mofe64/roadRunnerMiniV1/cad/biped_v02/renders_s68/s68_1_wall_outside_left.png

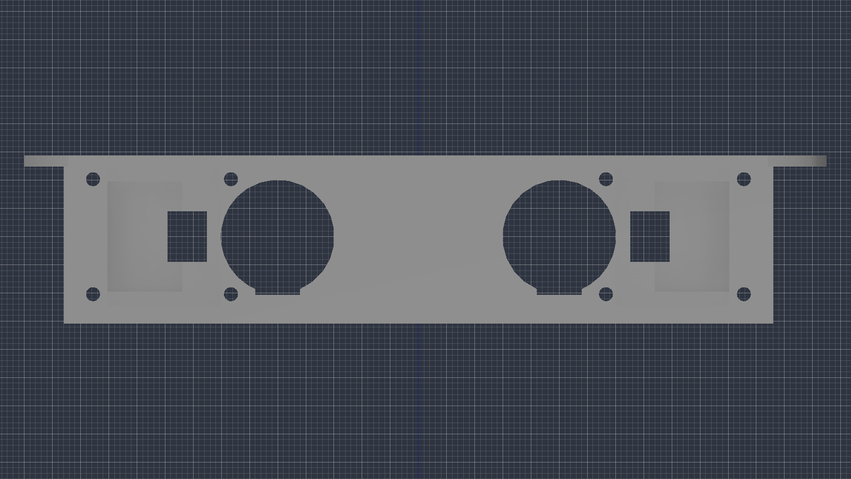
cad/biped_v02/renders_s68/s68_1_wall_outside_left.png
