mofe64/roadRunnerMiniV1/cad/biped_v02/renders_s68/s68_3_iso_with_hip_servos.png

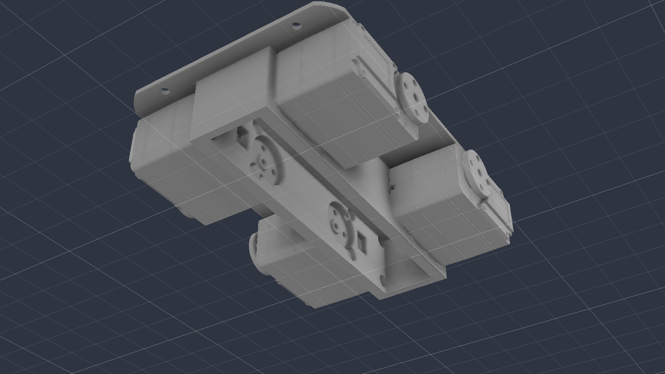
cad/biped_v02/renders_s68/s68_3_iso_with_hip_servos.png
