mofe64/roadRunnerMiniV1/cad/biped_v02/renders_s69/s69_1_base_top.png

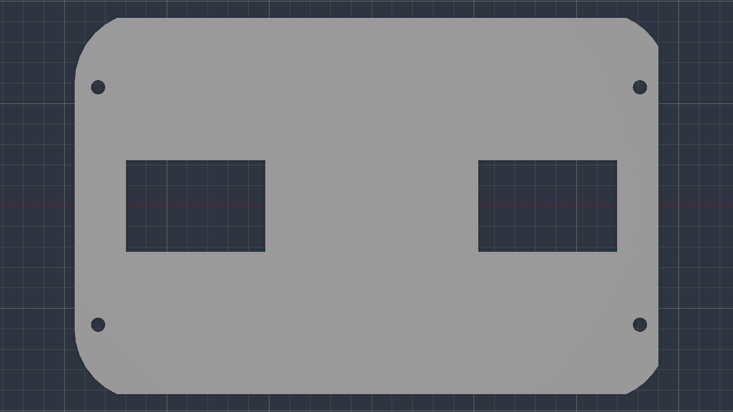
cad/biped_v02/renders_s69/s69_1_base_top.png
