mofe64/roadRunnerMiniV1/cad/biped_v02/renders_s69/s69_2_base_iso.png

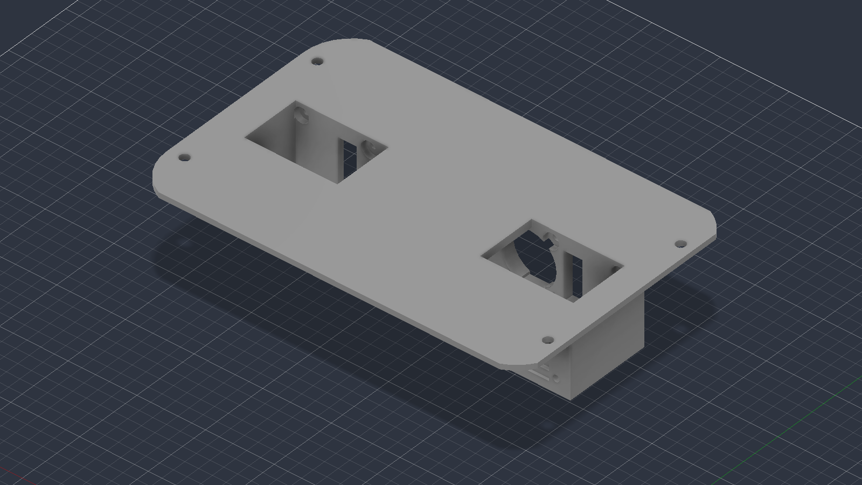
cad/biped_v02/renders_s69/s69_2_base_iso.png
