mofe64/roadRunnerMiniV1/cad/biped_v02/renders_s69/s69_3_base_iso_servos.png

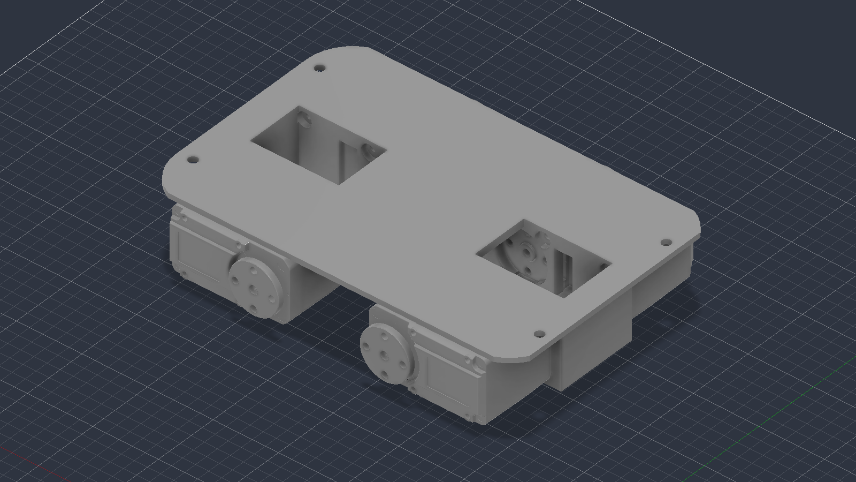
cad/biped_v02/renders_s69/s69_3_base_iso_servos.png
