mofe64/roadRunnerMiniV1/cad/biped_v02/renders_s70/s70_1_upper_front_pads.png

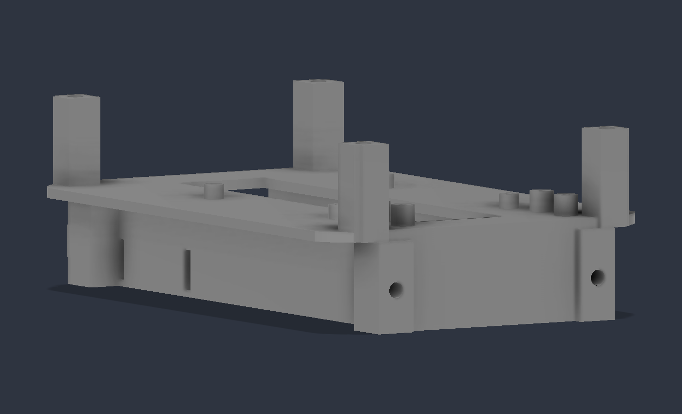
cad/biped_v02/renders_s70/s70_1_upper_front_pads.png
