mofe64/roadRunnerMiniV1/cad/biped_v02/renders_s70/s70_2_tray_front.png

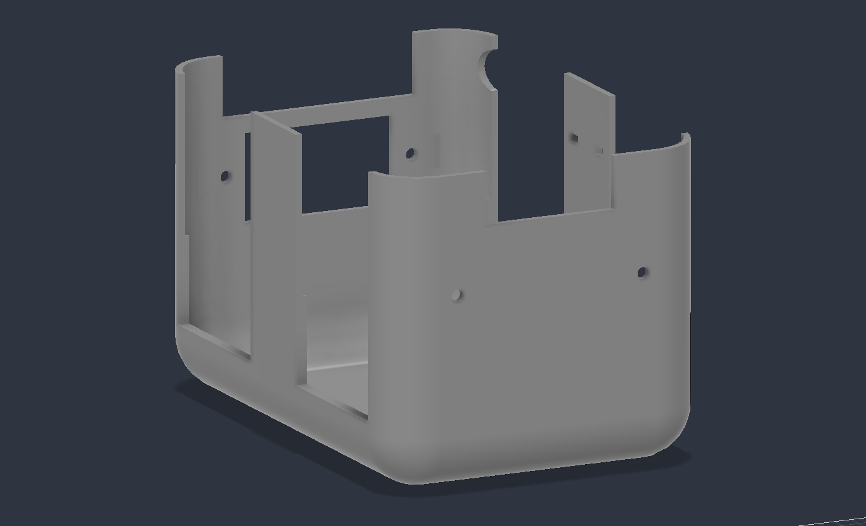
cad/biped_v02/renders_s70/s70_2_tray_front.png
