mofe64/roadRunnerMiniV1/cad/biped_v02/renders_s70/s70_3_deck_top.png

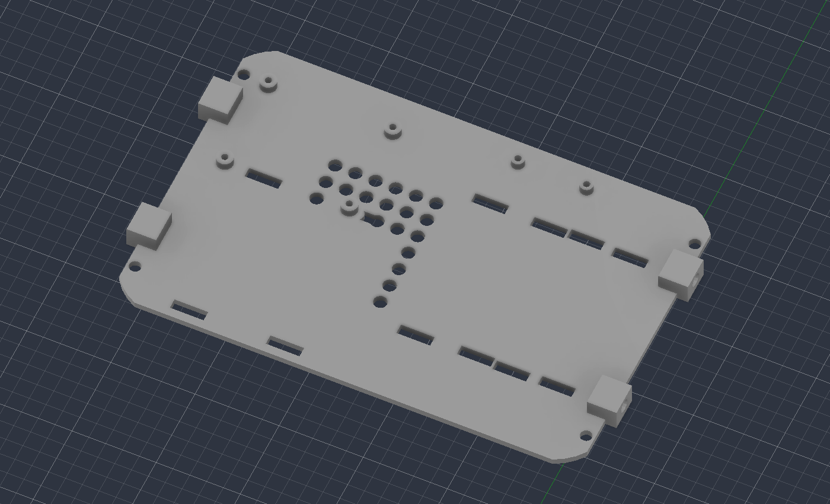
cad/biped_v02/renders_s70/s70_3_deck_top.png
