mofe64/roadRunnerMiniV1/cad/biped_v02/renders_s72/s72_deck_iso.png

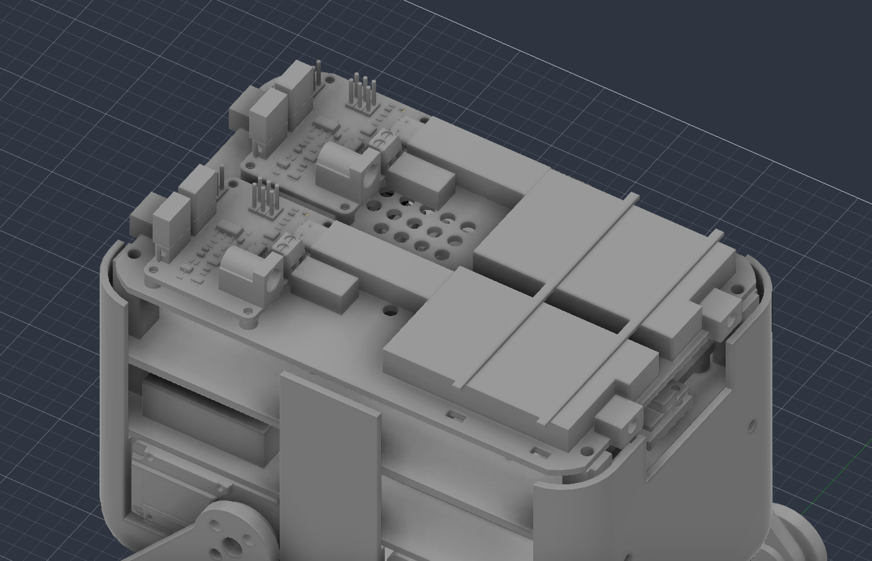
cad/biped_v02/renders_s72/s72_deck_iso.png
