mofe64/roadRunnerMiniV1/renders/biped_v02/v02c_iso_front.png

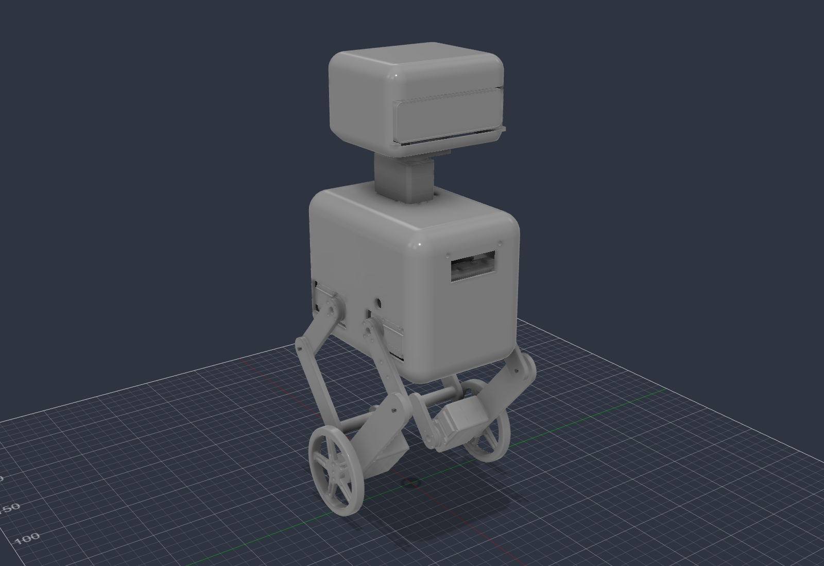
renders/biped_v02/v02c_iso_front.png
