mofe64/roadRunnerMiniV1/renders/biped_v02/v02c_neck_closeup.png

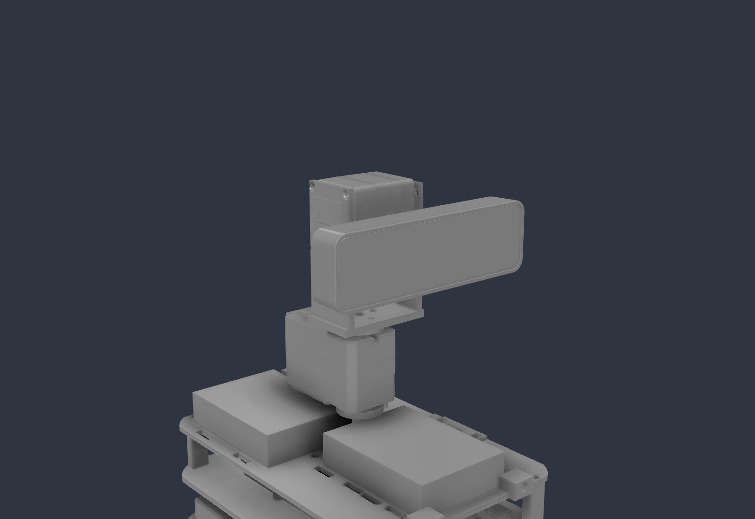
renders/biped_v02/v02c_neck_closeup.png
