mofe64/roadRunnerMiniV1/renders/biped_v02/v02d_oak_mount.png

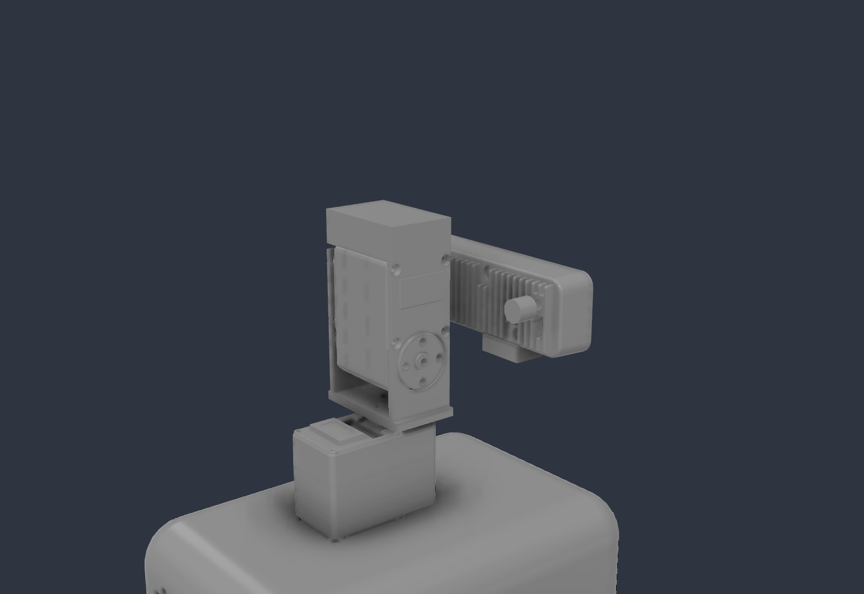
renders/biped_v02/v02d_oak_mount.png
