mofe64/roadRunnerMiniV1/renders/neck/bracket_top.png

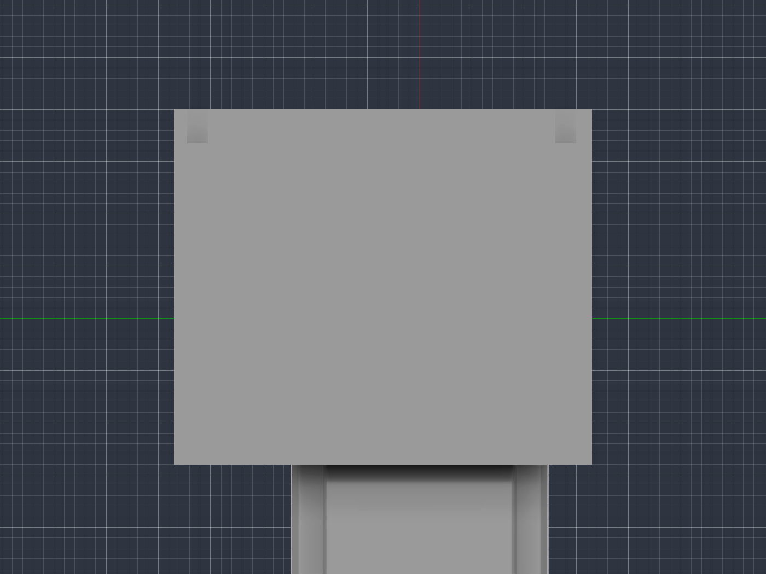
renders/neck/bracket_top.png
