mofe64/roadRunnerMiniV1/renders/neck/bracket_underside.png

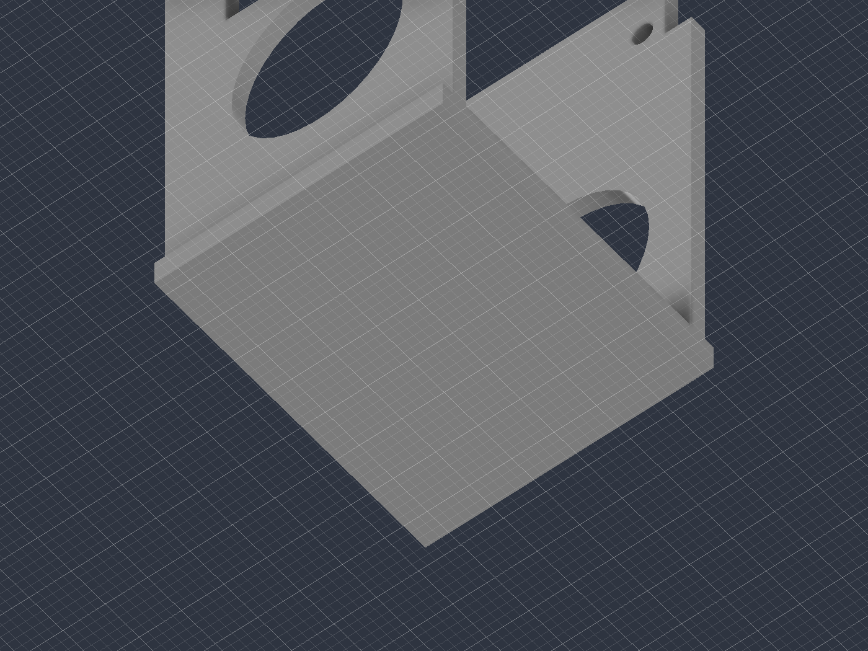
renders/neck/bracket_underside.png
