mofe64/roadRunnerMiniV1/renders/neck/head_below_drive.png

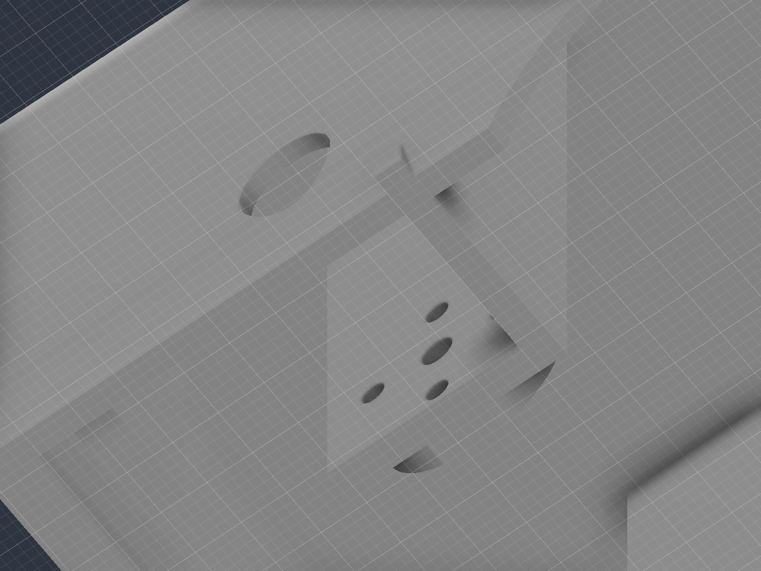
renders/neck/head_below_drive.png
