mofe64/roadRunnerMiniV1/renders/neck/head_side_drive.png

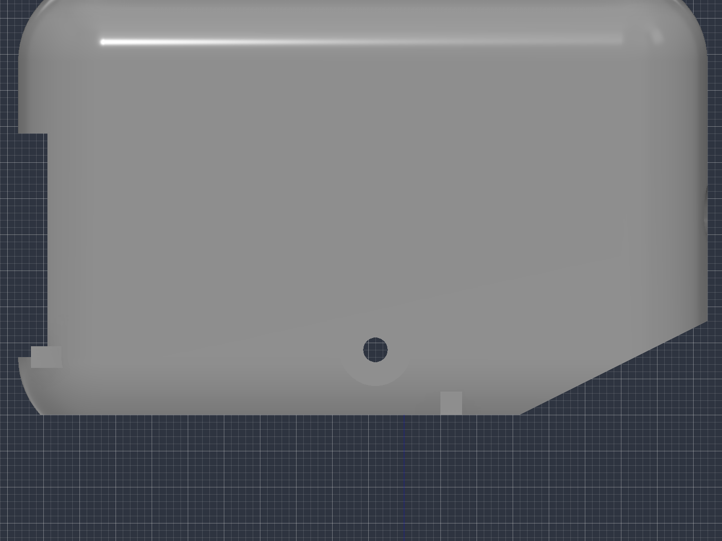
renders/neck/head_side_drive.png
