mofe64/roadRunnerMiniV1/renders/neck/plain_front_below.png

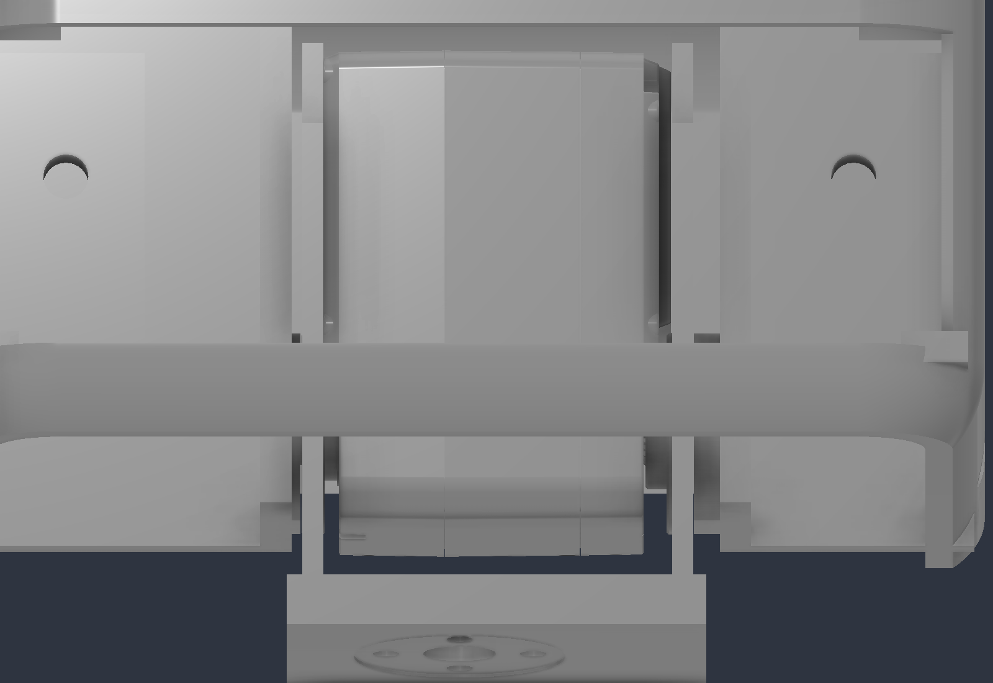
renders/neck/plain_front_below.png
