mofe64/roadRunnerMiniV1/renders/neck/s54_lid_top.png

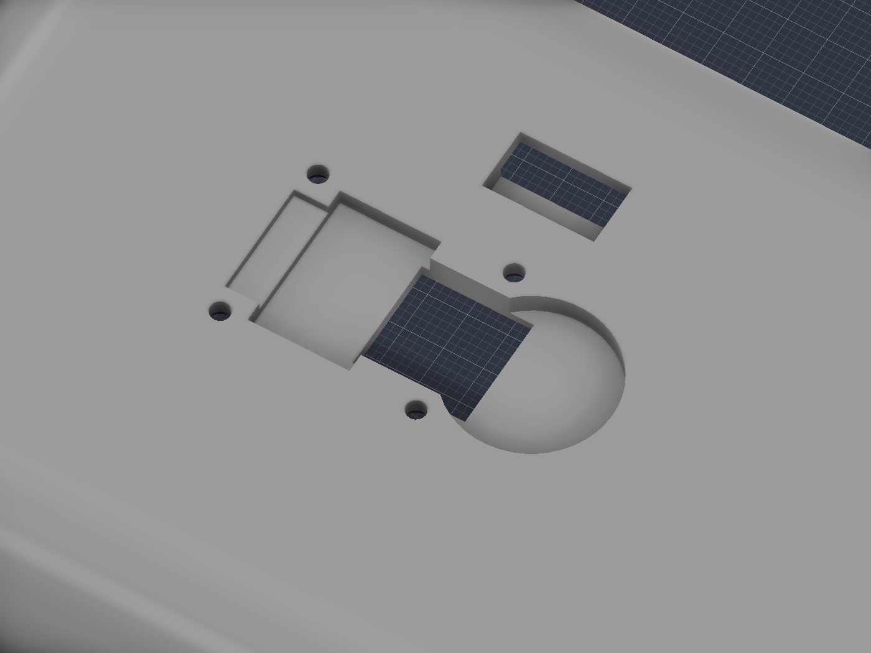
renders/neck/s54_lid_top.png
