mofe64/roadRunnerMiniV1/renders/neck/s54_neck_side.png

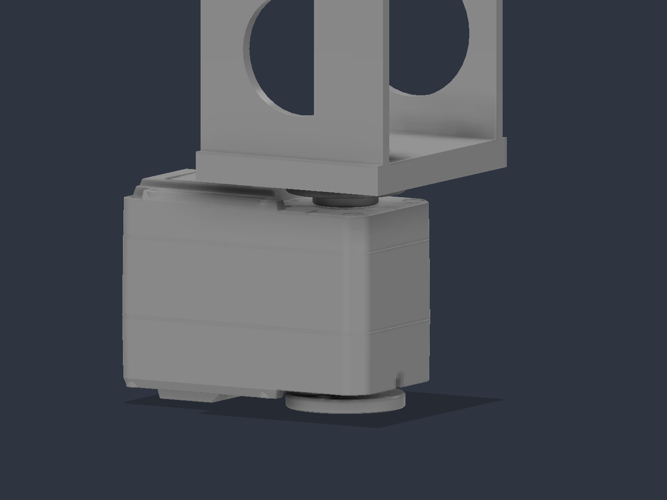
renders/neck/s54_neck_side.png
