mofe64/roadRunnerMiniV1/renders/neck/s54_neck_with_lid.png

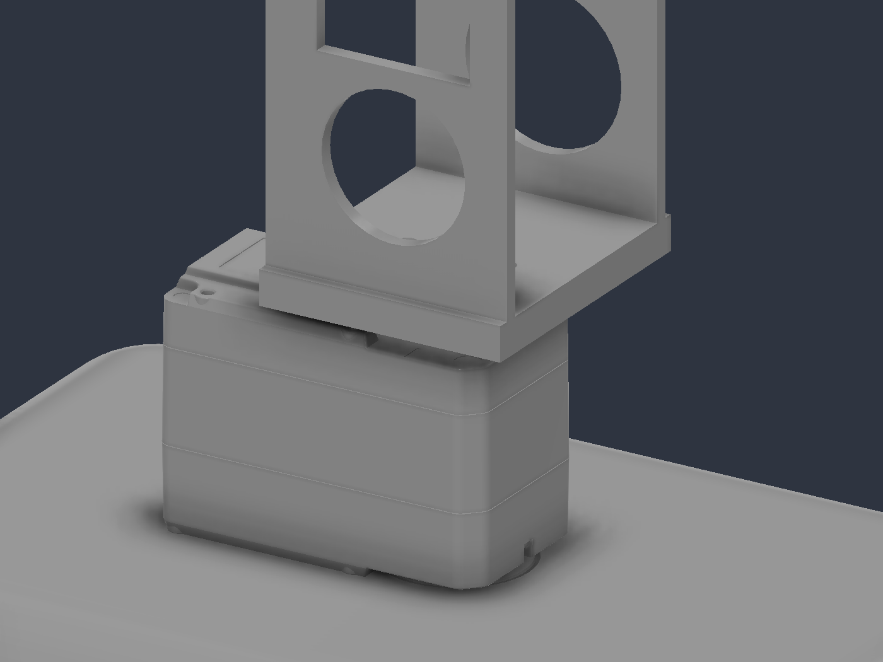
renders/neck/s54_neck_with_lid.png
