mofe64/roadRunnerMiniV1/renders/neck/yaw_below.png

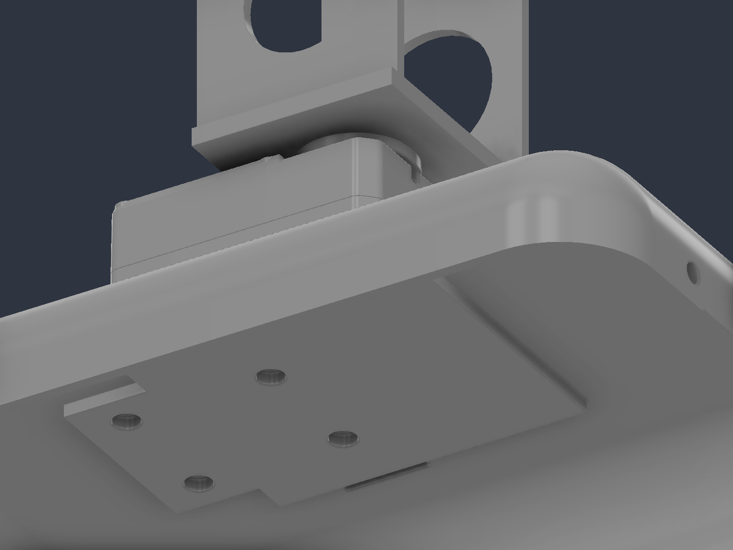
renders/neck/yaw_below.png
