mofe64/roadRunnerMiniV1/renders/neck/yaw_nolid_below.png

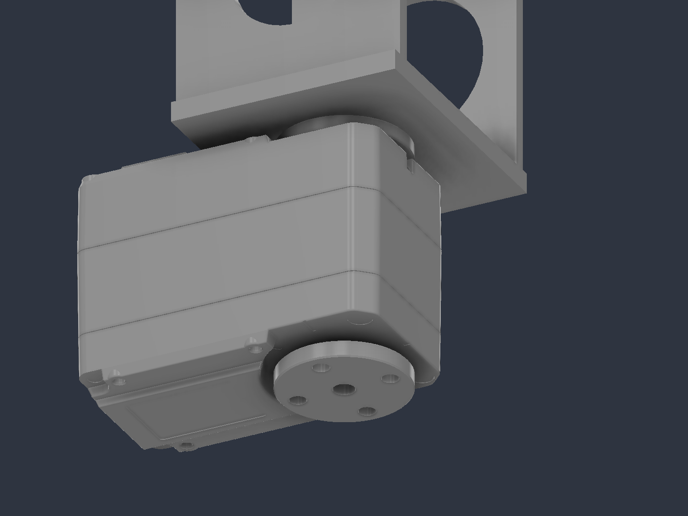
renders/neck/yaw_nolid_below.png
