mofe64/roadRunnerMiniV1/renders/neck/yaw_side.png

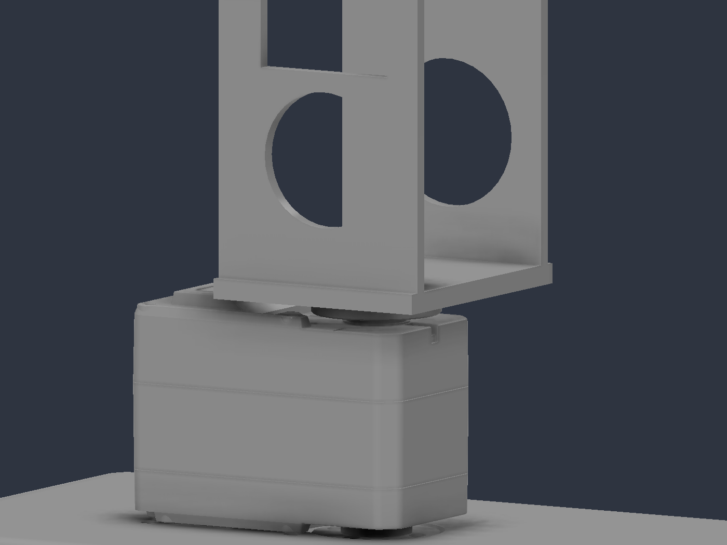
renders/neck/yaw_side.png
