mofe64/roadRunnerMiniV1/renders/s65_iso_robot.png

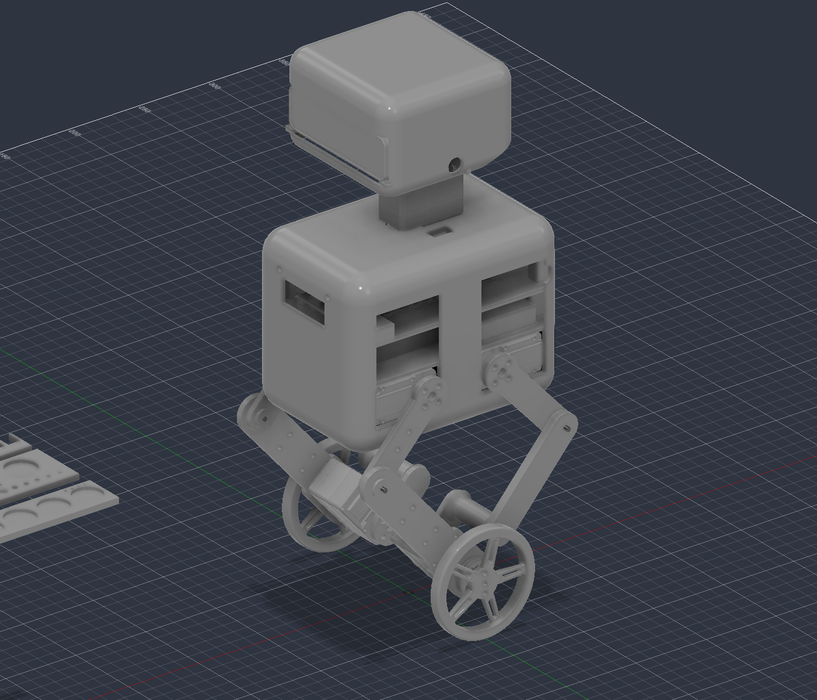
renders/s65_iso_robot.png
