mofe64/roadRunnerMiniV1/renders/s65_iso_tray_close.png

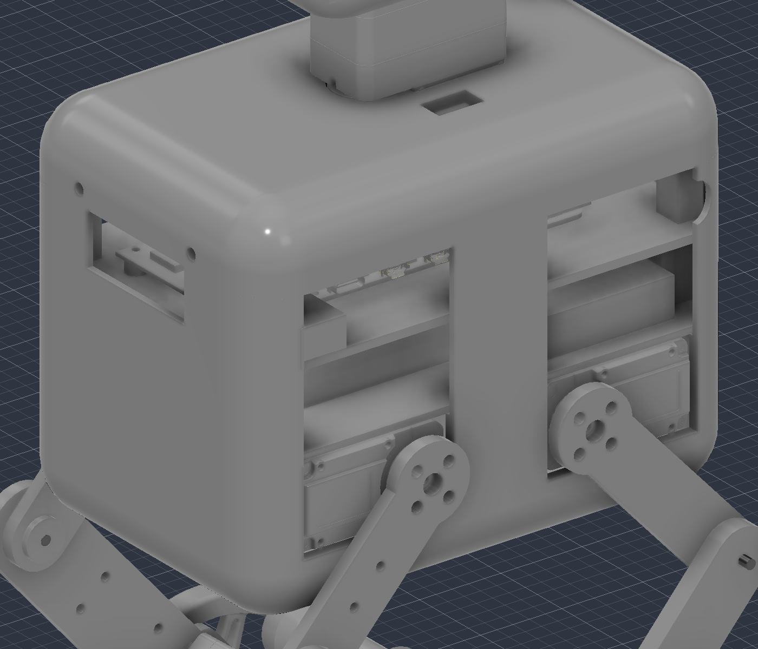
renders/s65_iso_tray_close.png
