mofe64/roadRunnerMiniV1/renders/s65_side_left.png

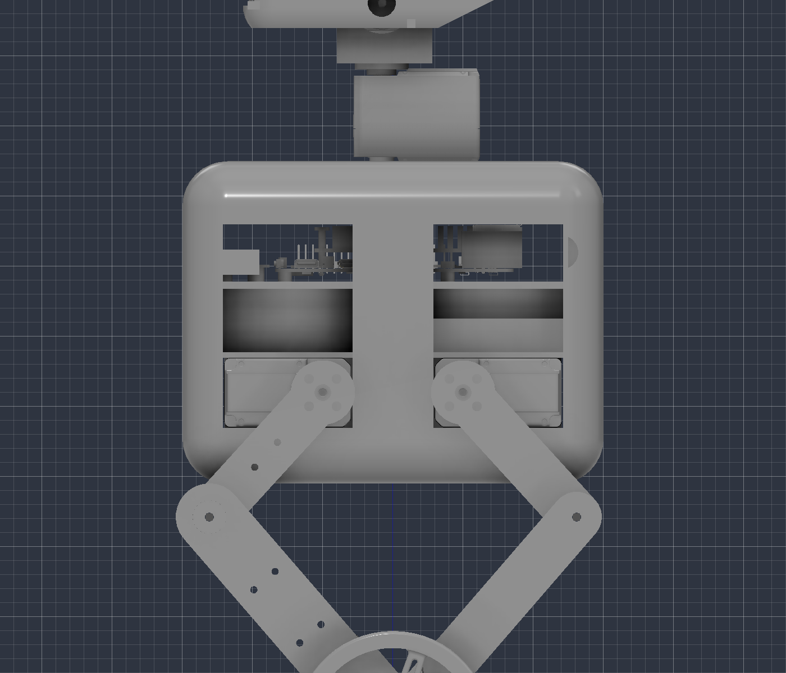
renders/s65_side_left.png
