mofe64/roadRunnerMiniV1/renders/wheeled_biped_references.jpg

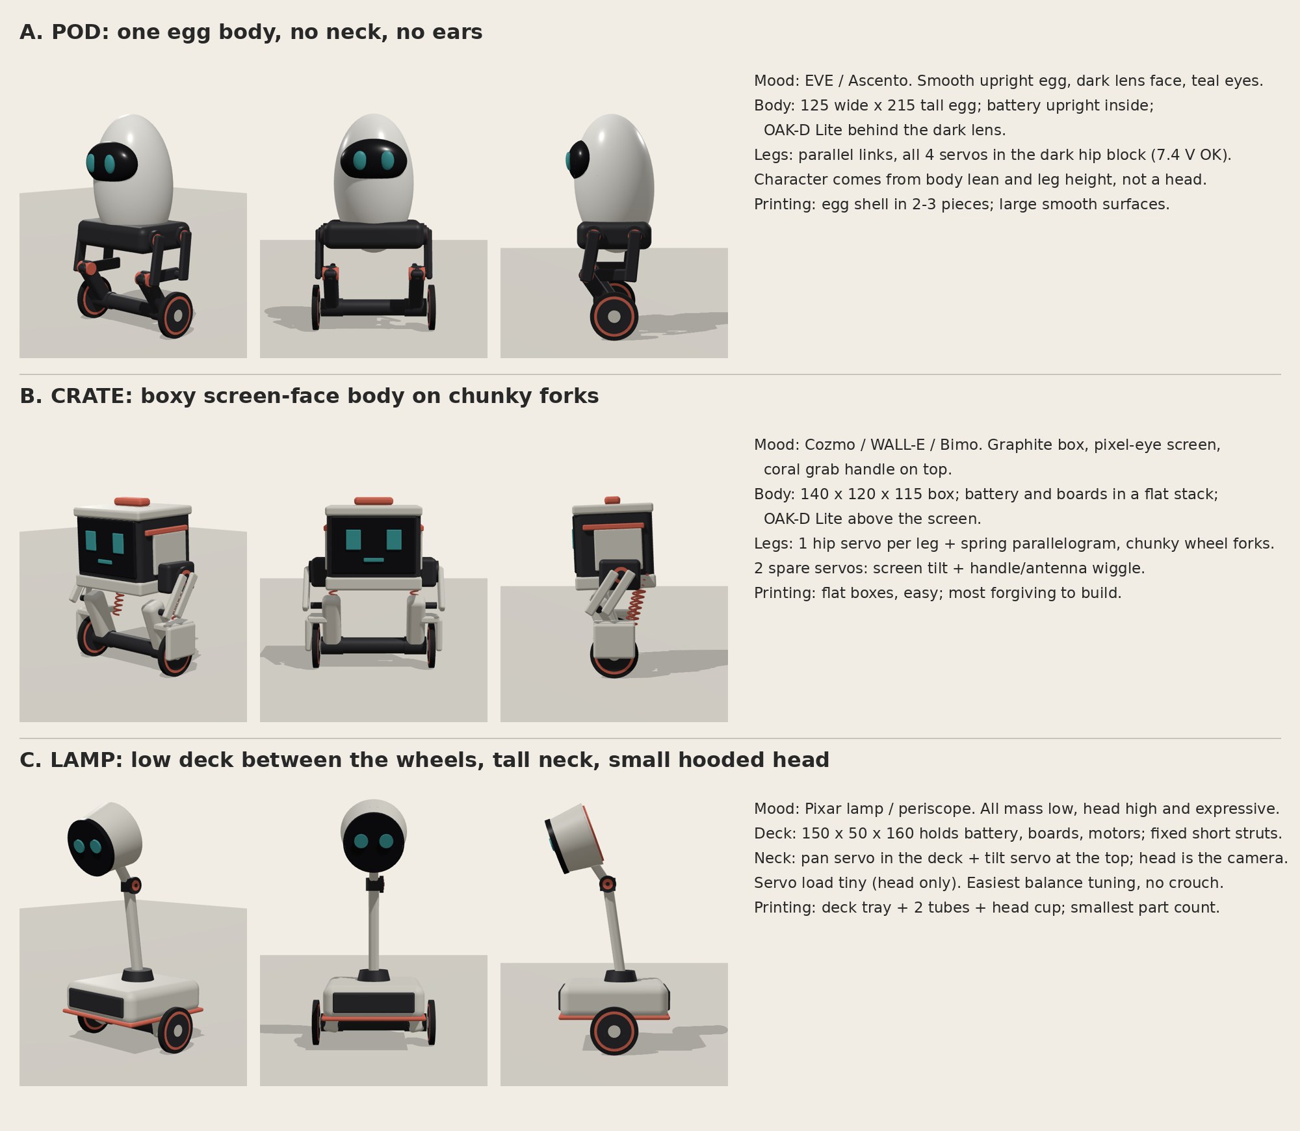
renders/wheeled_biped_references.jpg
