mofe64/roadRunnerMiniV1/cad/biped_v02/coupon/coupon_plate.stl

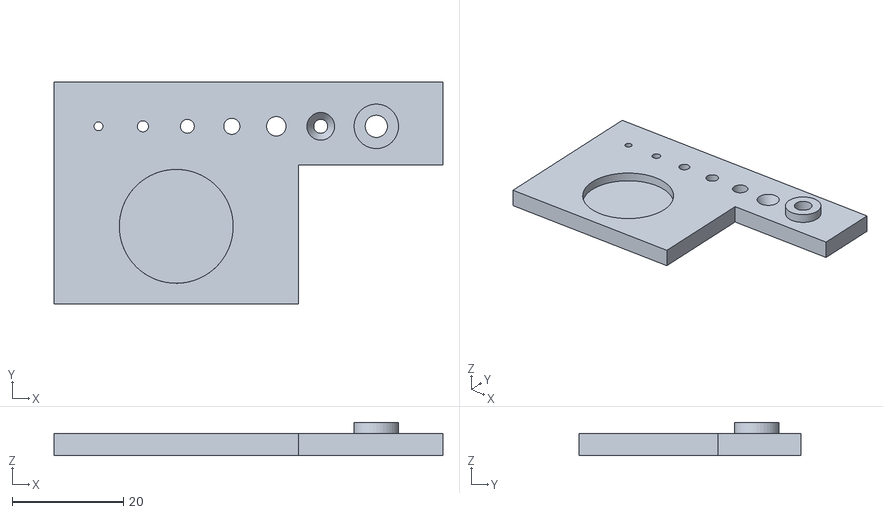
[picture p29: CAD file, 2026-10-27]
cad/biped_v02/coupon/coupon_plate.stl
70.0 x 40.0 x 6.00
