mofe64/roadRunnerMiniV1/cad/biped_v02/plates/plate_9_imu_plate.3mf

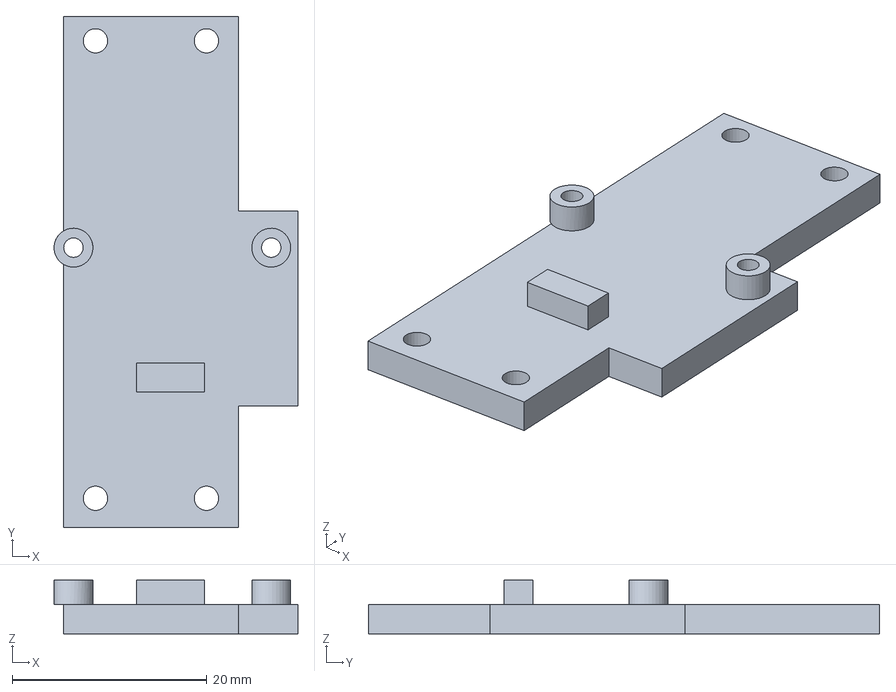
[picture p30: CAD file, 2026-11-11]
cad/biped_v02/plates/plate_9_imu_plate.3mf
25.1 x 52.5 x 5.50 mm
