mofe64/roadRunnerMiniV1/cad/biped_v02/stl/upper_deck.stl

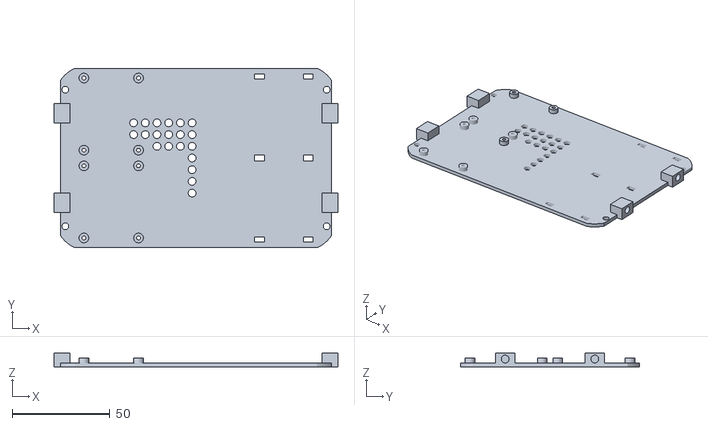
[picture p31: CAD file, 2026-11-11]
cad/biped_v02/stl/upper_deck.stl
145.6 x 92.0 x 7.00
