mofe64/roadRunnerMiniV1/sim/meshes/torso_pi.stl

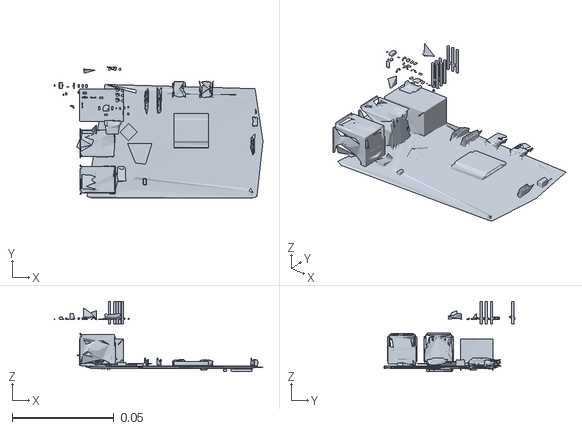
[picture p32: CAD file, 2026-10-31]
sim/meshes/torso_pi.stl
0.103 x 0.0646 x 0.0346
