mofe64/roadRunnerMiniV1/sim/meshes_raw/oak.stl

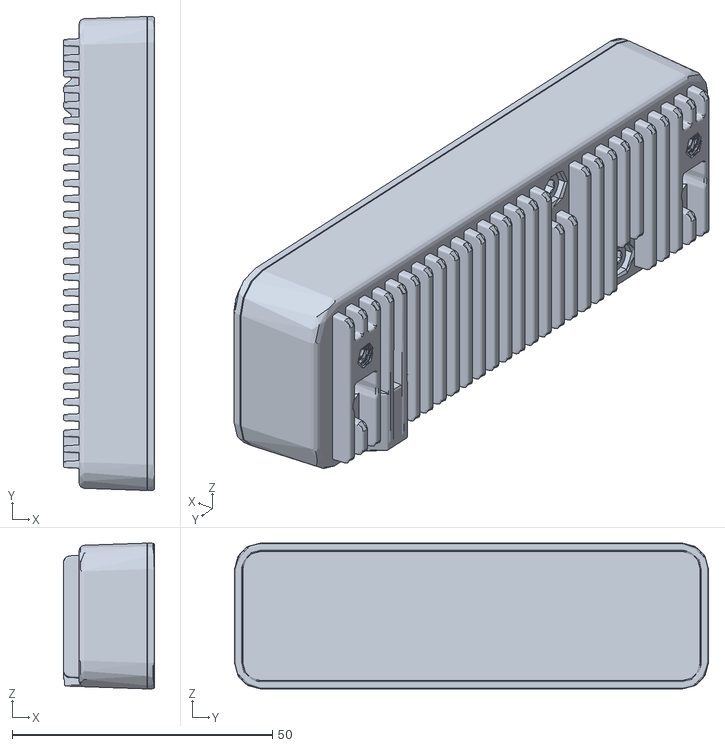
[picture p33: CAD file, 2026-10-31]
sim/meshes_raw/oak.stl
17.4 x 91.0 x 28.0
