mofe64/roadRunnerMiniV1/cad/biped_v02/coupon/coupon_all.stl

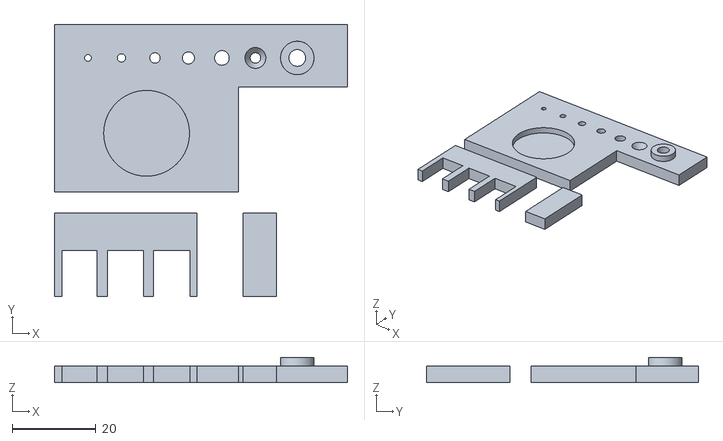
[picture p34: CAD file, 2026-10-27]
cad/biped_v02/coupon/coupon_all.stl
70.0 x 65.0 x 6.00
