mofe64/roadRunnerMiniV1/sim/meshes/low_f_L.stl

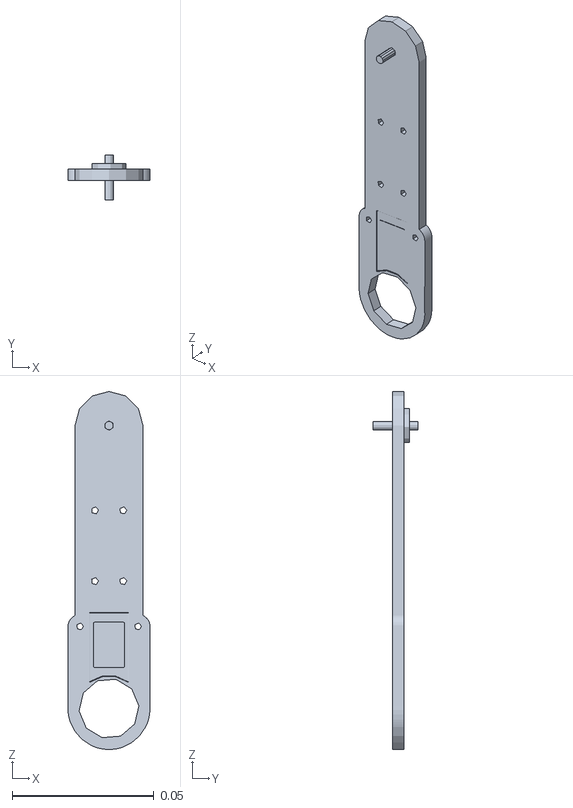
[picture p35: CAD file, 2026-10-31]
sim/meshes/low_f_L.stl
0.029 x 0.016 x 0.126
