mofe64/roadRunnerMiniV1/sim/meshes_raw/head.stl

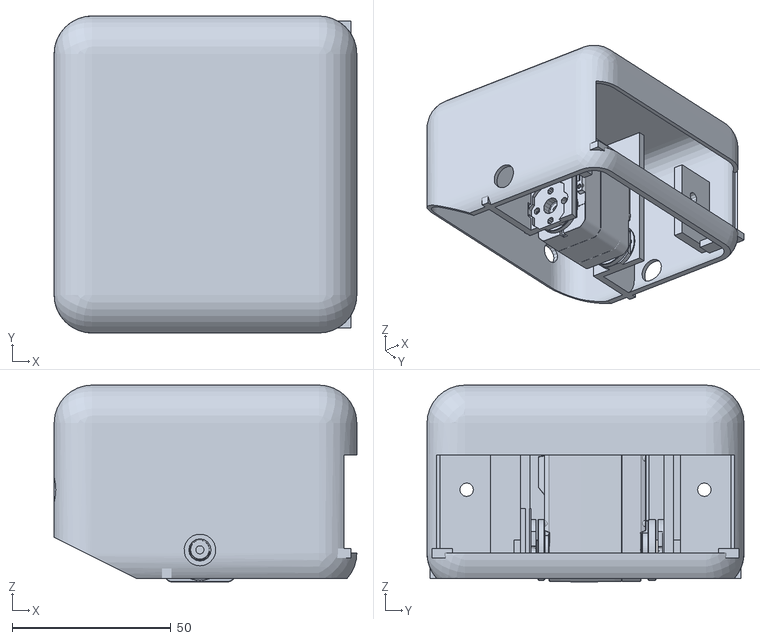
[picture p36: CAD file, 2026-10-31]
sim/meshes_raw/head.stl
95.5 x 100.0 x 62.1
