mofe64/roadRunnerMiniV1/cad/biped_v02/coupon/coupon_tab.stl

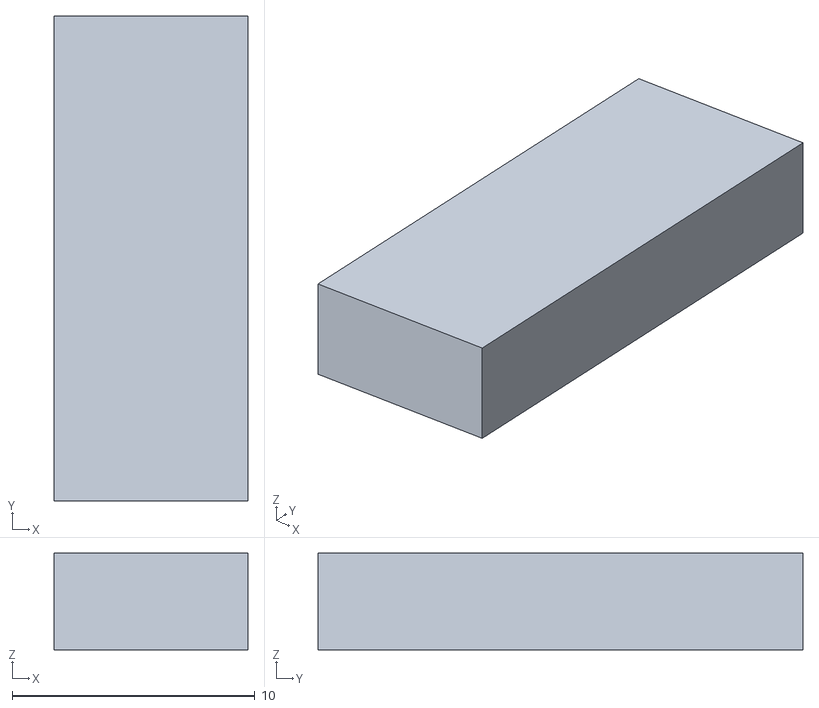
[picture p37: CAD file, 2026-10-27]
cad/biped_v02/coupon/coupon_tab.stl
8.00 x 20.0 x 4.00
