mofe64/roadRunnerMiniV1/cad/biped_v02/plates/plate_5b_chassis_upper.3mf

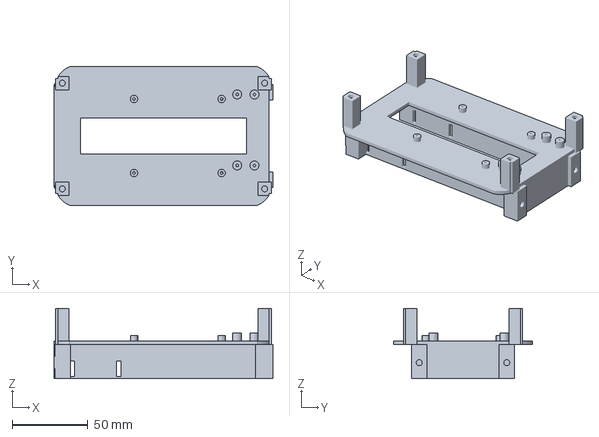
[picture p38: CAD file, 2026-11-06]
cad/biped_v02/plates/plate_5b_chassis_upper.3mf
145.0 x 92.0 x 46.6 mm
