mofe64/roadRunnerMiniV1/cad/biped_v02/stl/chassis_lower.stl

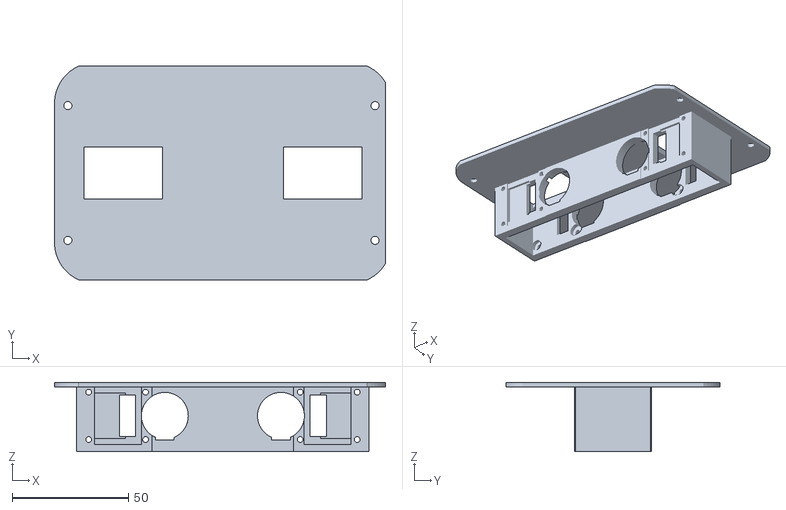
[picture p39: CAD file, 2026-11-06]
cad/biped_v02/stl/chassis_lower.stl
142.5 x 92.0 x 29.8
