mofe64/roadRunnerMiniV1/sim/meshes/low_r_L.stl

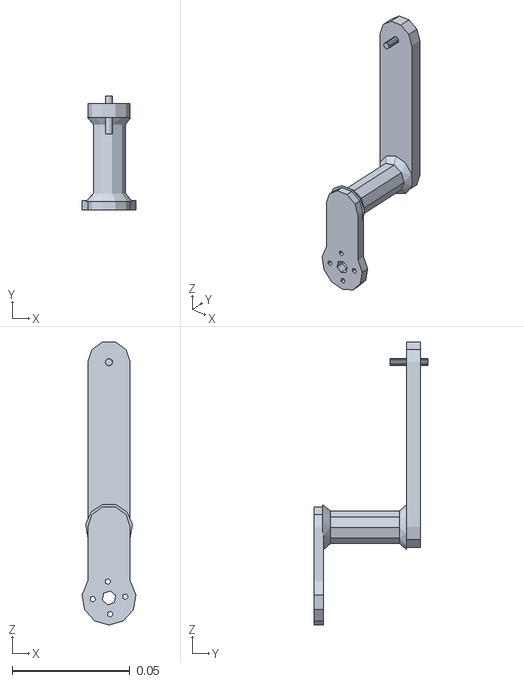
[picture p40: CAD file, 2026-10-31]
sim/meshes/low_r_L.stl
0.0229 x 0.0482 x 0.12
