mofe64/roadRunnerMiniV1/sim/meshes_raw/torso_shell_S63.stl

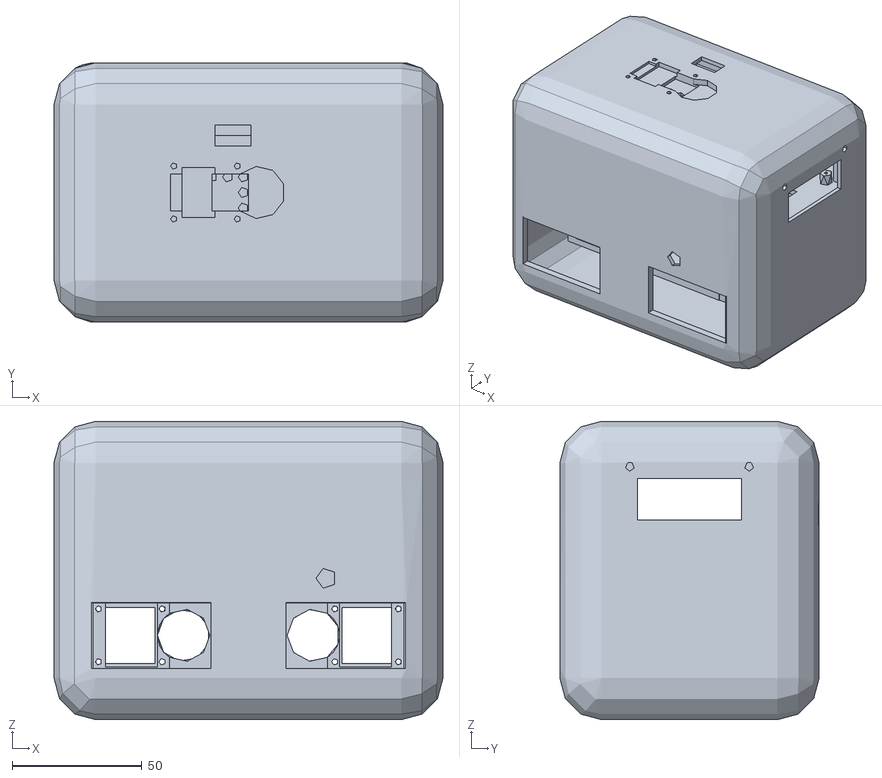
[picture p41: CAD file, 2026-10-31]
sim/meshes_raw/torso_shell_S63.stl
150.0 x 100.0 x 115.0
