mofe64/roadRunnerMiniV1/cad/biped_v02/coupon/coupon_horn_gauge.stl

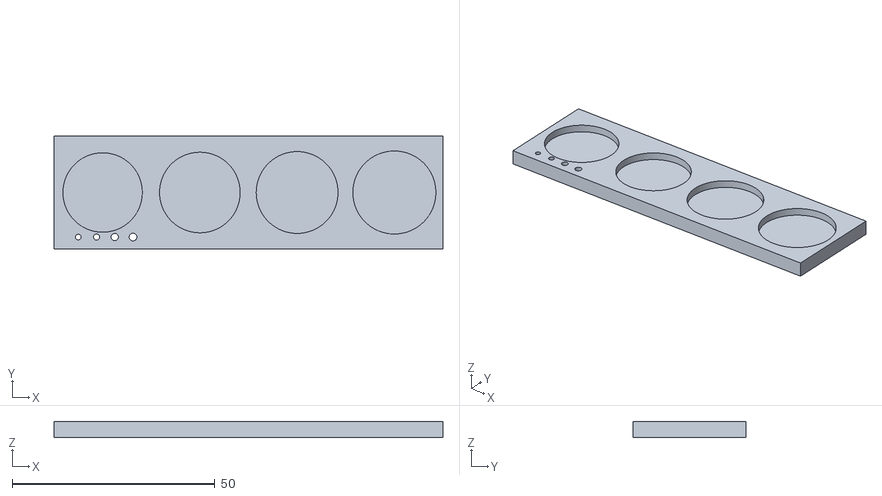
[picture p42: CAD file, 2026-10-27]
cad/biped_v02/coupon/coupon_horn_gauge.stl
96.0 x 28.0 x 4.00
