mofe64/roadRunnerMiniV1/sim/meshes/wheel_L.stl

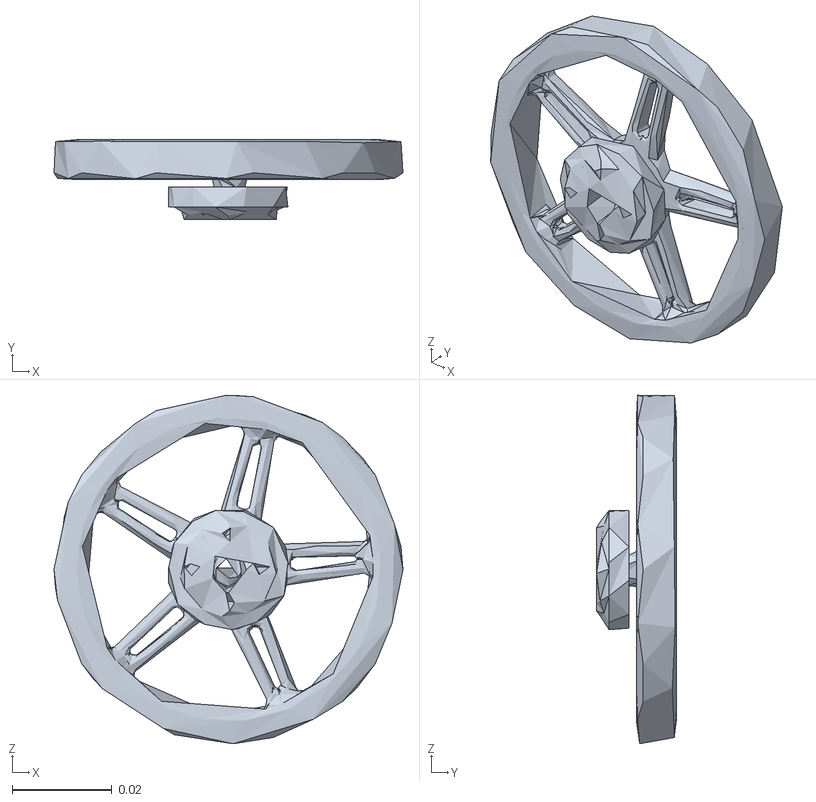
[picture p43: CAD file, 2026-10-31]
sim/meshes/wheel_L.stl
0.07 x 0.016 x 0.0699
