mofe64/roadRunnerMiniV1/cad/biped_v02/coupon/coupon_fork.stl

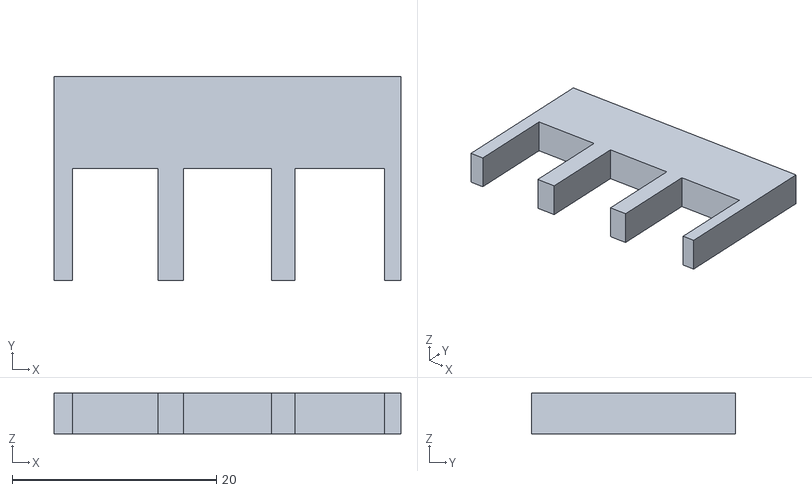
[picture p44: CAD file, 2026-10-27]
cad/biped_v02/coupon/coupon_fork.stl
34.0 x 20.0 x 4.00
