mofe64/roadRunnerMiniV1/cad/biped_v02/plates/plate_7_tray.3mf

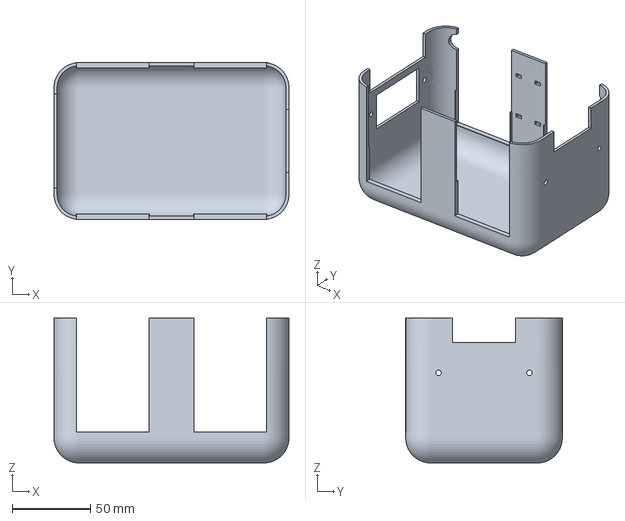
[picture p45: CAD file, 2026-11-06]
cad/biped_v02/plates/plate_7_tray.3mf
150.0 x 100.0 x 92.5 mm
