mofe64/roadRunnerMiniV1/sim/meshes/up_f_R.stl

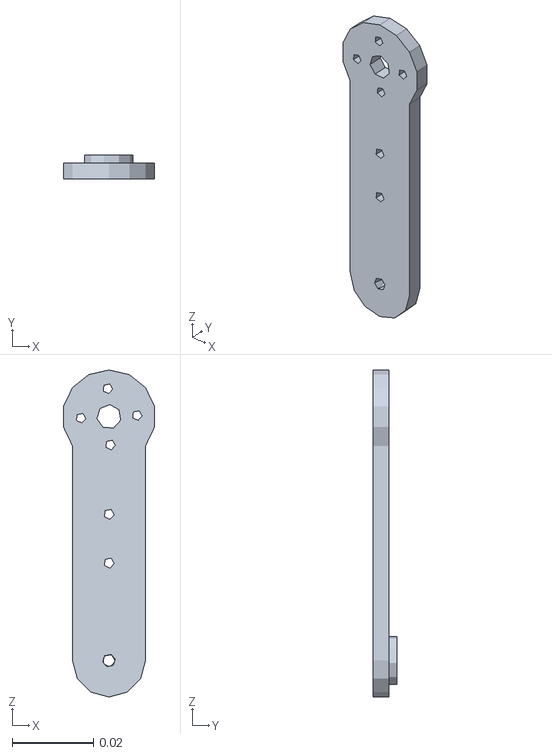
[picture p46: CAD file, 2026-10-31]
sim/meshes/up_f_R.stl
0.0224 x 0.006 x 0.0805
