mofe64/roadRunnerMiniV1/cad/biped_v02/plates/plate_8_lid.3mf

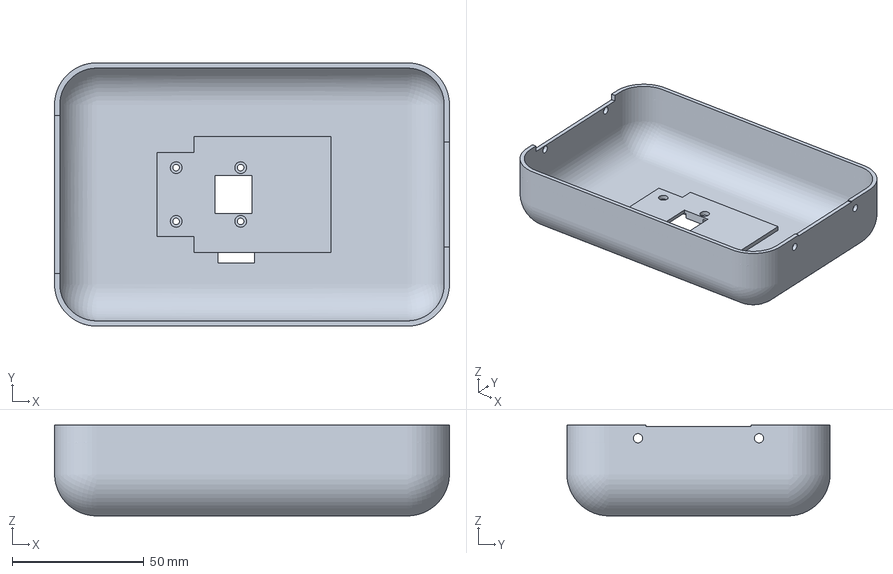
[picture p47: CAD file, 2026-10-31]
cad/biped_v02/plates/plate_8_lid.3mf
150.0 x 100.0 x 34.5 mm
