mofe64/roadRunnerMiniV1/cad/biped_v02/stl/upper_rear_R.stl

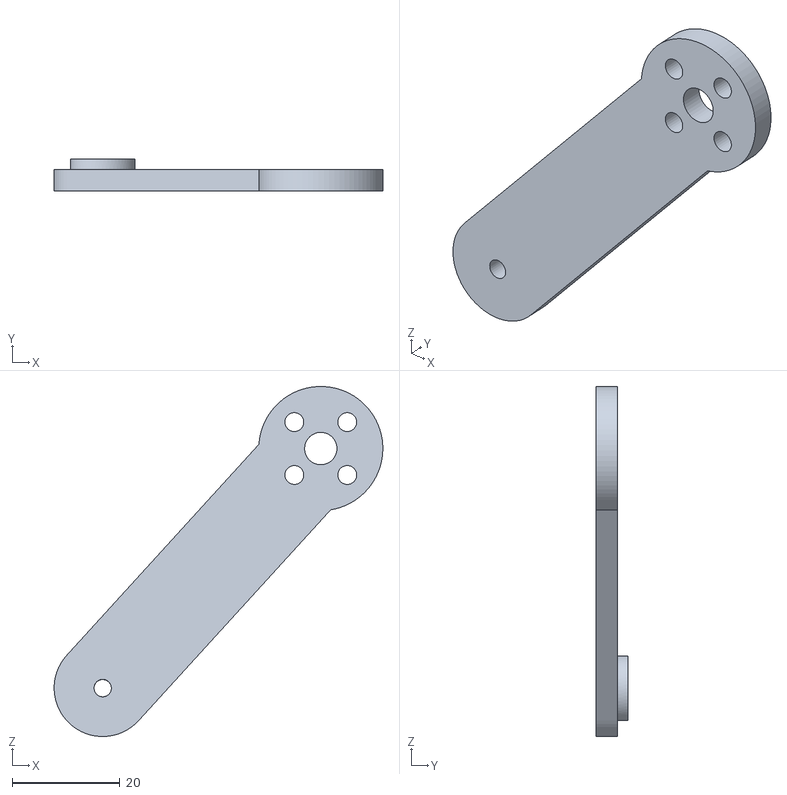
[picture p48: CAD file, 2026-10-31]
cad/biped_v02/stl/upper_rear_R.stl
60.9 x 6.00 x 64.8
