mofe64/roadRunnerMiniV1/sim/meshes/head.stl

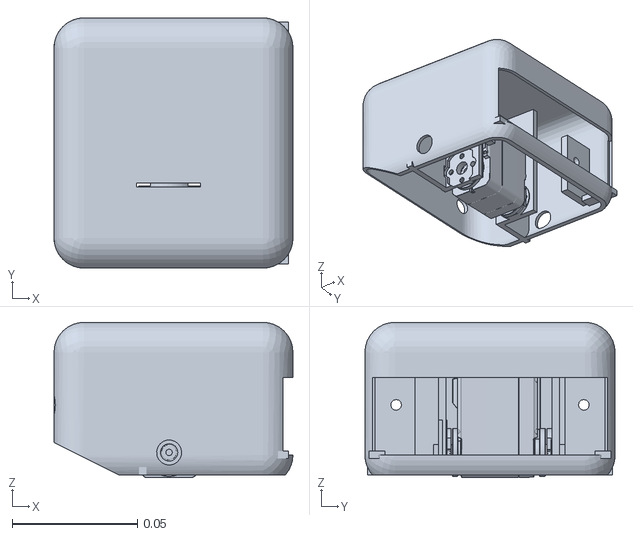
[picture p49: CAD file, 2026-10-31]
sim/meshes/head.stl
0.0955 x 0.1 x 0.0621
