mofe64/roadRunnerMiniV1/cad/biped_v02/plates/plate_2_upper_links_hubs.3mf

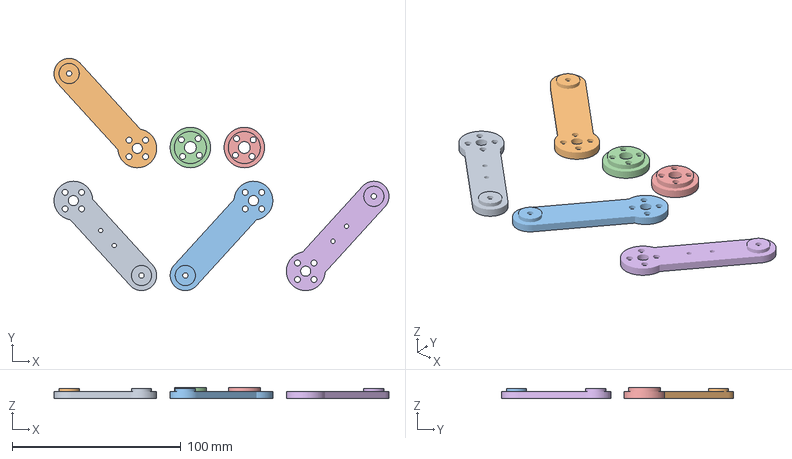
[picture p50: CAD file, 2026-10-31]
cad/biped_v02/plates/plate_2_upper_links_hubs.3mf
198.7 x 137.7 x 6.50 mm
plate_2_upper_links_hubs_1
plate_2_upper_links_hubs_2
plate_2_upper_links_hubs_3
plate_2_upper_links_hubs_4
plate_2_upper_links_hubs_5
plate_2_upper_links_hubs_6
