mofe64/roadRunnerMiniV1/cad/biped_v02/stl/pitch_bracket.stl

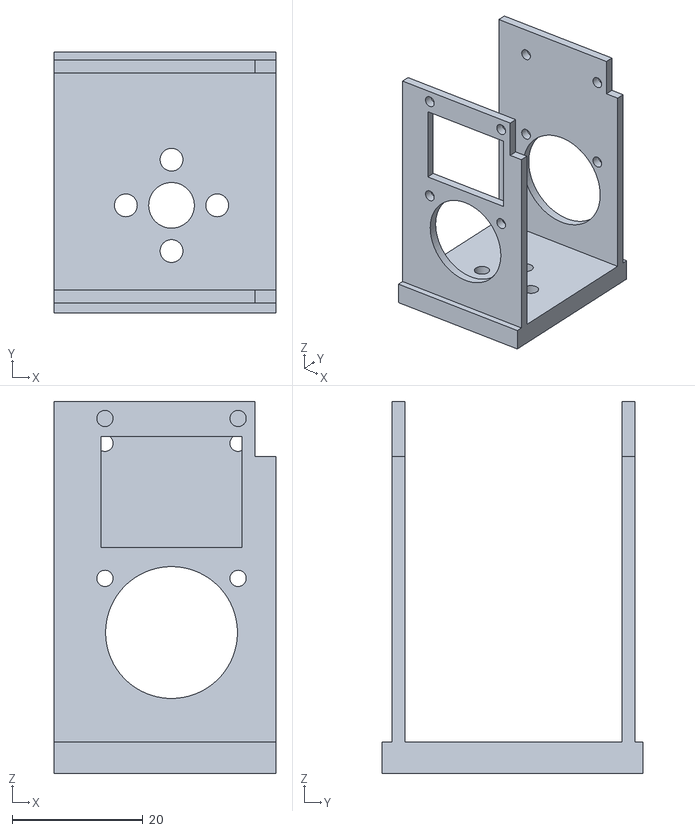
[picture p51: CAD file, 2026-10-31]
cad/biped_v02/stl/pitch_bracket.stl
34.0 x 40.0 x 57.0
