mofe64/roadRunnerMiniV1/cad/biped_v02/plates/plate_3_lower_front.3mf

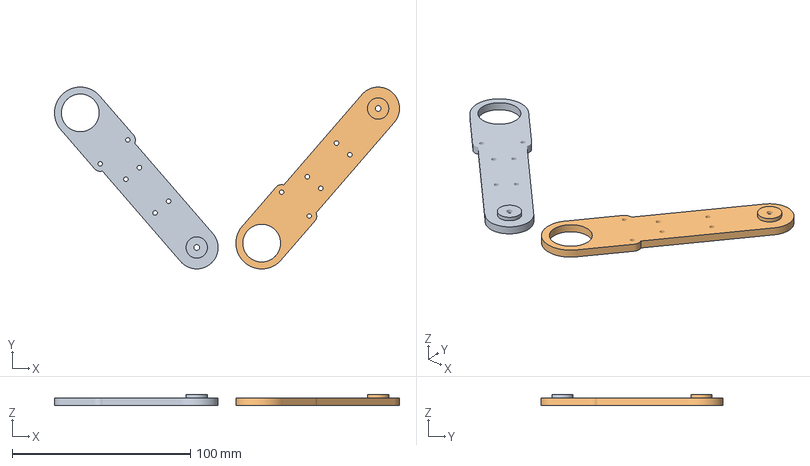
[picture p53: CAD file, 2026-10-31]
cad/biped_v02/plates/plate_3_lower_front.3mf
193.8 x 102.1 x 5.95 mm
plate_3_lower_front_1
plate_3_lower_front_2
