mofe64/roadRunnerMiniV1/sim/meshes/torso_shell.stl

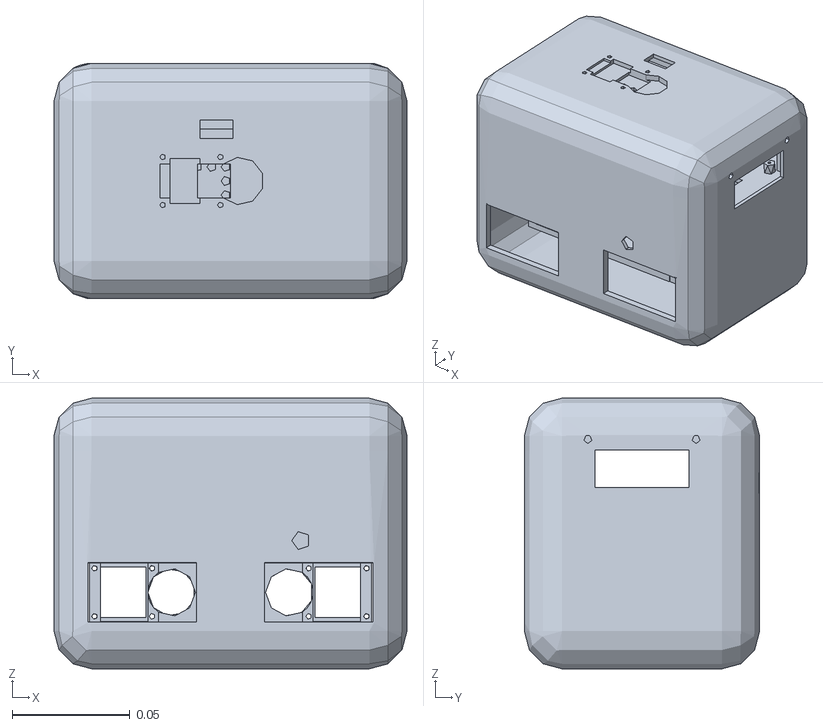
[picture p54: CAD file, 2026-10-31]
sim/meshes/torso_shell.stl
0.15 x 0.1 x 0.115
