mofe64/roadRunnerMiniV1/cad/biped_v02/stl/hub_L.stl

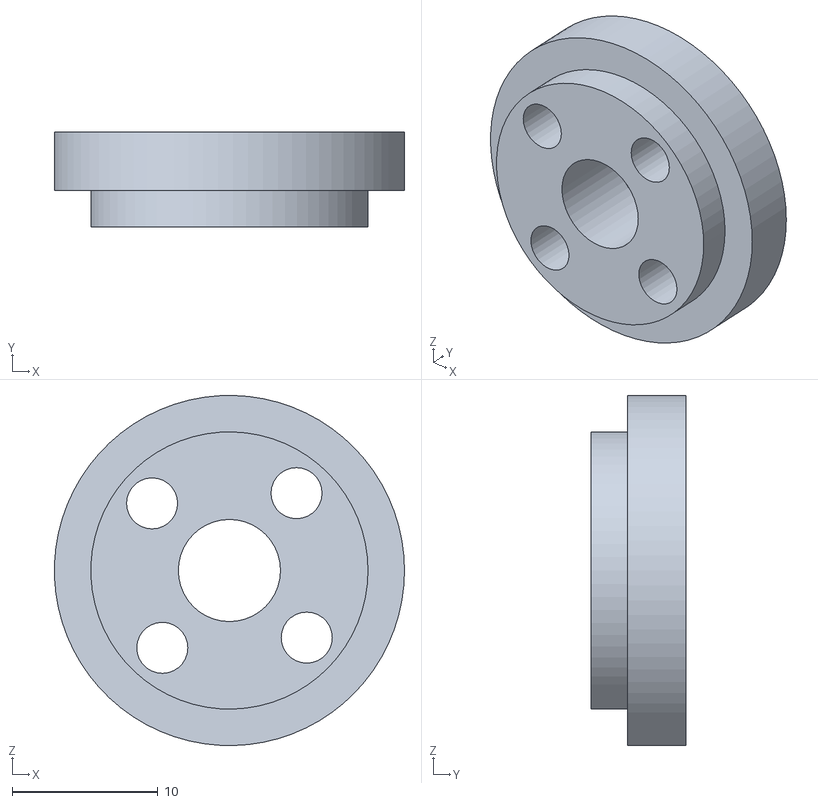
[picture p55: CAD file, 2026-10-31]
cad/biped_v02/stl/hub_L.stl
24.0 x 6.50 x 24.0
