mofe64/roadRunnerMiniV1/sim/meshes/axle_R.stl

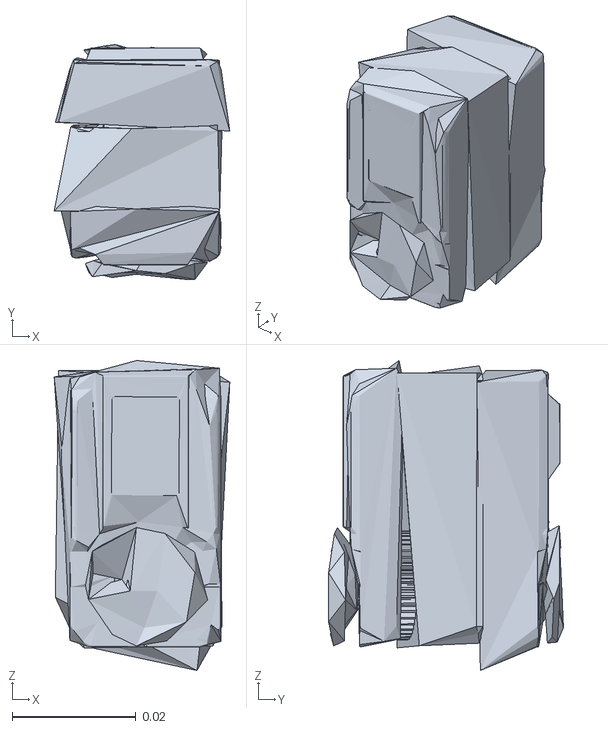
[picture p56: CAD file, 2026-10-31]
sim/meshes/axle_R.stl
0.0284 x 0.0379 x 0.0501
