mofe64/roadRunnerMiniV1/cad/biped_v02/plates/plate_4_lower_rear.3mf

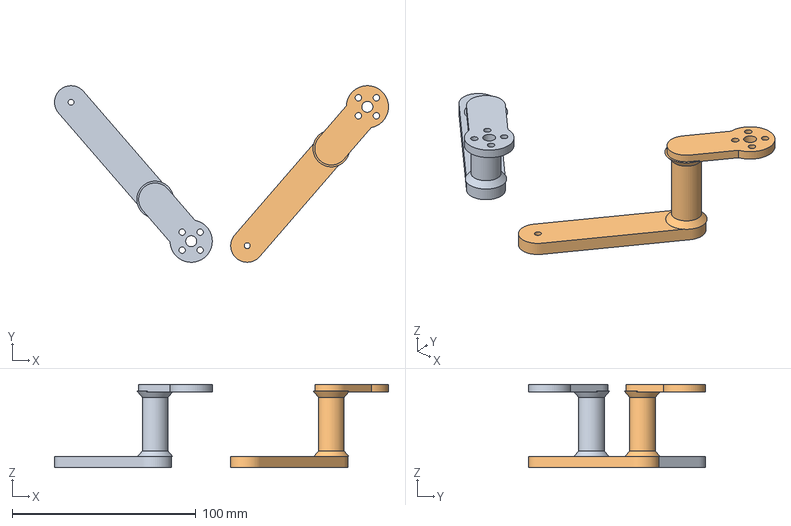
[picture p57: CAD file, 2026-10-31]
cad/biped_v02/plates/plate_4_lower_rear.3mf
181.8 x 96.1 x 45.2 mm
plate_4_lower_rear_1
plate_4_lower_rear_2
