mofe64/roadRunnerMiniV1/cad/biped_v02/plates/plate_1_head.3mf

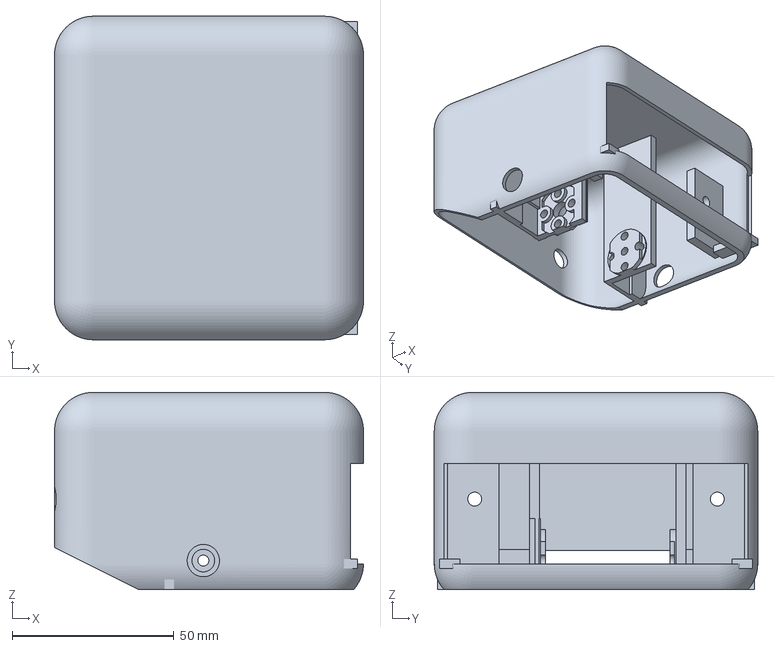
[picture p58: CAD file, 2026-10-31]
cad/biped_v02/plates/plate_1_head.3mf
95.5 x 100.0 x 61.0 mm
