mofe64/roadRunnerMiniV1/sim/meshes/axle_L.stl

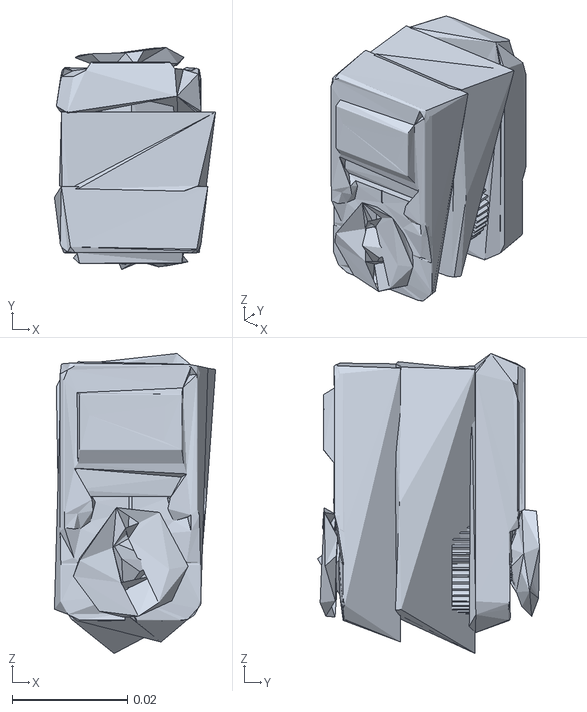
[picture p59: CAD file, 2026-10-31]
sim/meshes/axle_L.stl
0.028 x 0.0385 x 0.0521
