mofe64/roadRunnerMiniV1/cad/biped_v02/stl/lower_front_plate_R.stl

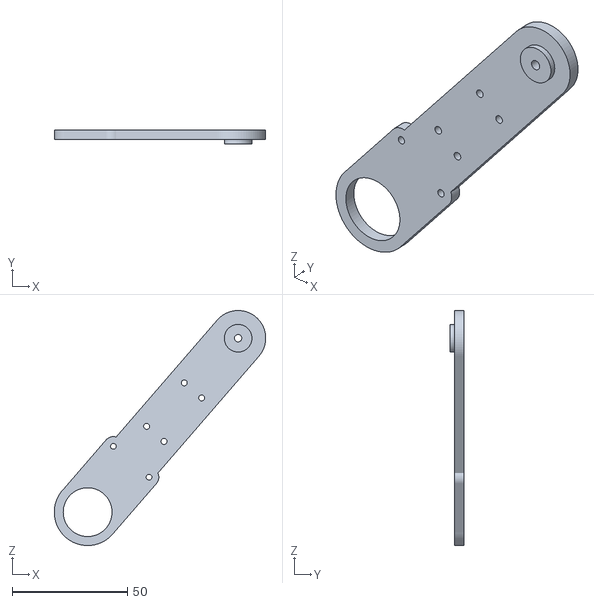
[picture p60: CAD file, 2026-10-31]
cad/biped_v02/stl/lower_front_plate_R.stl
91.9 x 5.95 x 102.1
