mofe64/roadRunnerMiniV1/sim/meshes/oak.stl

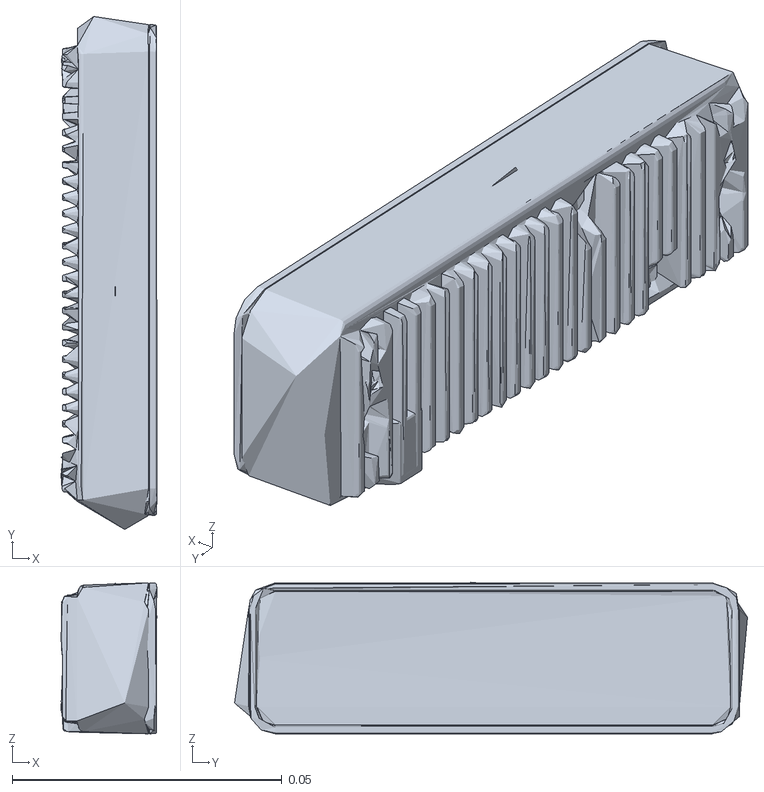
[picture p61: CAD file, 2026-10-31]
sim/meshes/oak.stl
0.0178 x 0.0951 x 0.0281
