mofe64/roadRunnerMiniV1/cad/biped_v02/stl/lower_rear_L.stl

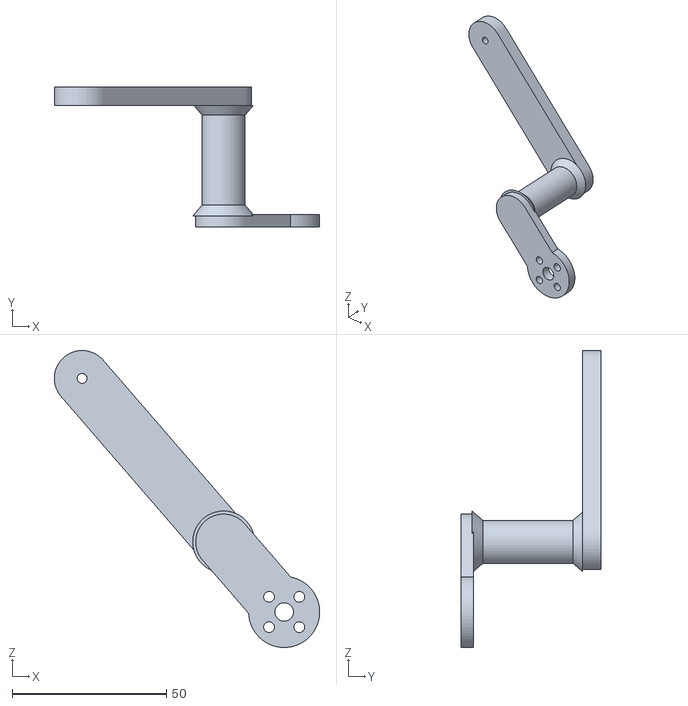
[picture p62: CAD file, 2026-10-31]
cad/biped_v02/stl/lower_rear_L.stl
85.9 x 45.2 x 96.1
