mofe64/roadRunnerMiniV1/sim/meshes/torso_parts.stl

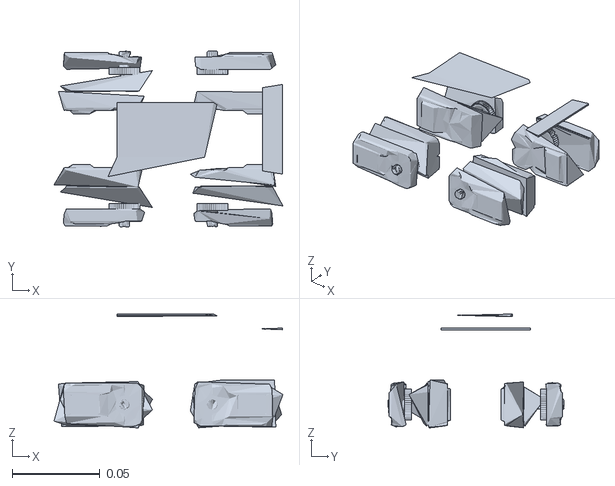
[picture p63: CAD file, 2026-10-31]
sim/meshes/torso_parts.stl
0.13 x 0.1 x 0.0648
