mofe64/roadRunnerMiniV1/sim/meshes/neck.stl

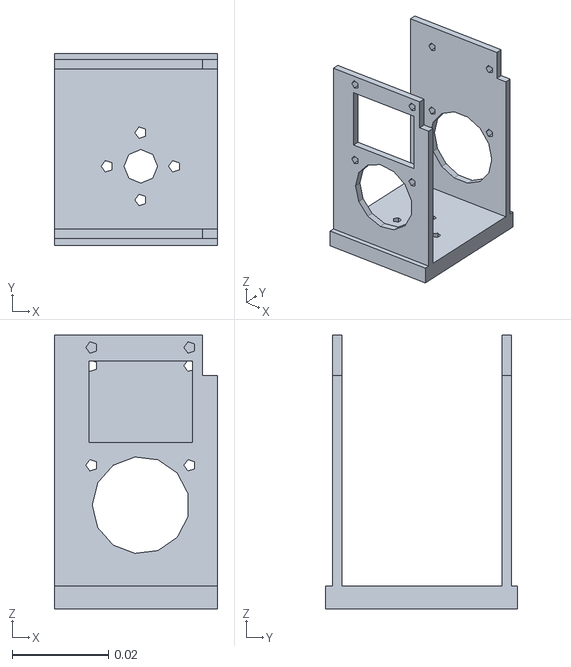
[picture p64: CAD file, 2026-10-31]
sim/meshes/neck.stl
0.034 x 0.04 x 0.057
