mofe64/roadRunnerMiniV1/sim/meshes/wheel_R.stl

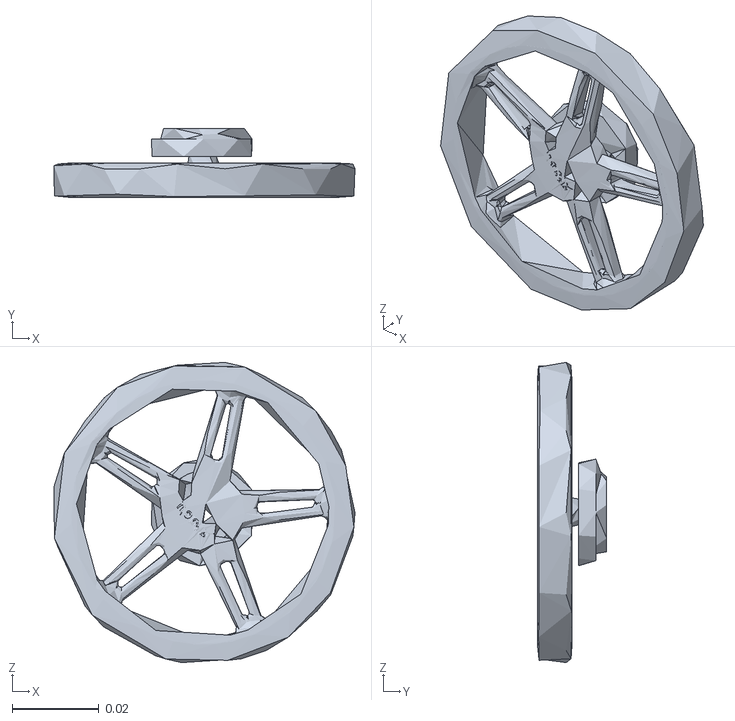
[picture p65: CAD file, 2026-10-31]
sim/meshes/wheel_R.stl
0.0695 x 0.016 x 0.0693
