mofe64/roadRunnerMiniV1/sim/meshes/yaw_servo.stl

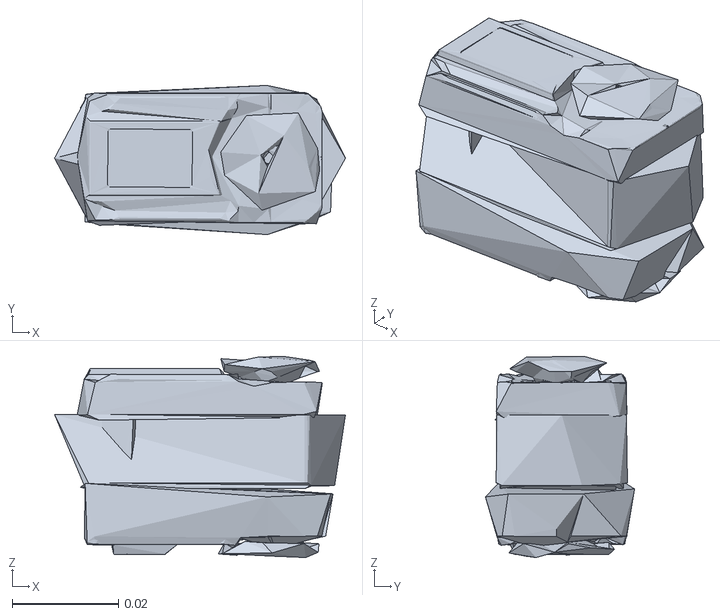
[picture p66: CAD file, 2026-10-31]
sim/meshes/yaw_servo.stl
0.0548 x 0.0281 x 0.0379
