mofe64/roadRunnerMiniV1/(list of files, cad)

Other CAD files:
cad/biped_v02/plates/plate_6_upper_deck.3mf
cad/biped_v02/stl/imu_plate.stl
cad/biped_v02/plates/plate_5a_chassis_lower.3mf
cad/biped_v02/stl/chassis_upper.stl
cad/biped_v02/stl/tray.stl
cad/biped_v02/stl/upper_front_R.stl
cad/biped_v02/plates/plate_1b_bracket_flat.3mf
cad/biped_v02/stl/upper_front_L.stl
sim/meshes/up_f_L.stl
cad/biped_v02/stl/head.stl
cad/biped_v02/stl/upper_rear_L.stl
sim/meshes/low_r_R.stl
sim/meshes/up_r_L.stl
cad/biped_v02/stl/lid.stl
cad/biped_v02/stl/lower_front_plate_L.stl
cad/biped_v02/stl/lower_rear_R.stl
sim/meshes/low_f_R.stl
cad/biped_v02/stl/hub_R.stl
cad/biped_v02/biped_v02_S51.f3d
cad/biped_v02/biped_v02_S61b.f3d
cad/biped_v02/biped_v02_S62.f3d
cad/biped_v02/biped_v02_S63.f3d
cad/biped_v02/biped_v02_S64.f3d
cad/biped_v02/biped_v02_S65.f3d
cad/biped_v02/biped_v02_S66.f3d
cad/biped_v02/biped_v02_S67.f3d
cad/biped_v02/biped_v02_S68.f3d
cad/biped_v02/biped_v02_S69.f3d
cad/biped_v02/biped_v02_S70.f3d
cad/biped_v02/biped_v02_S72.f3d
