mofe64/roadRunnerMiniV1/renders/print_plates.png

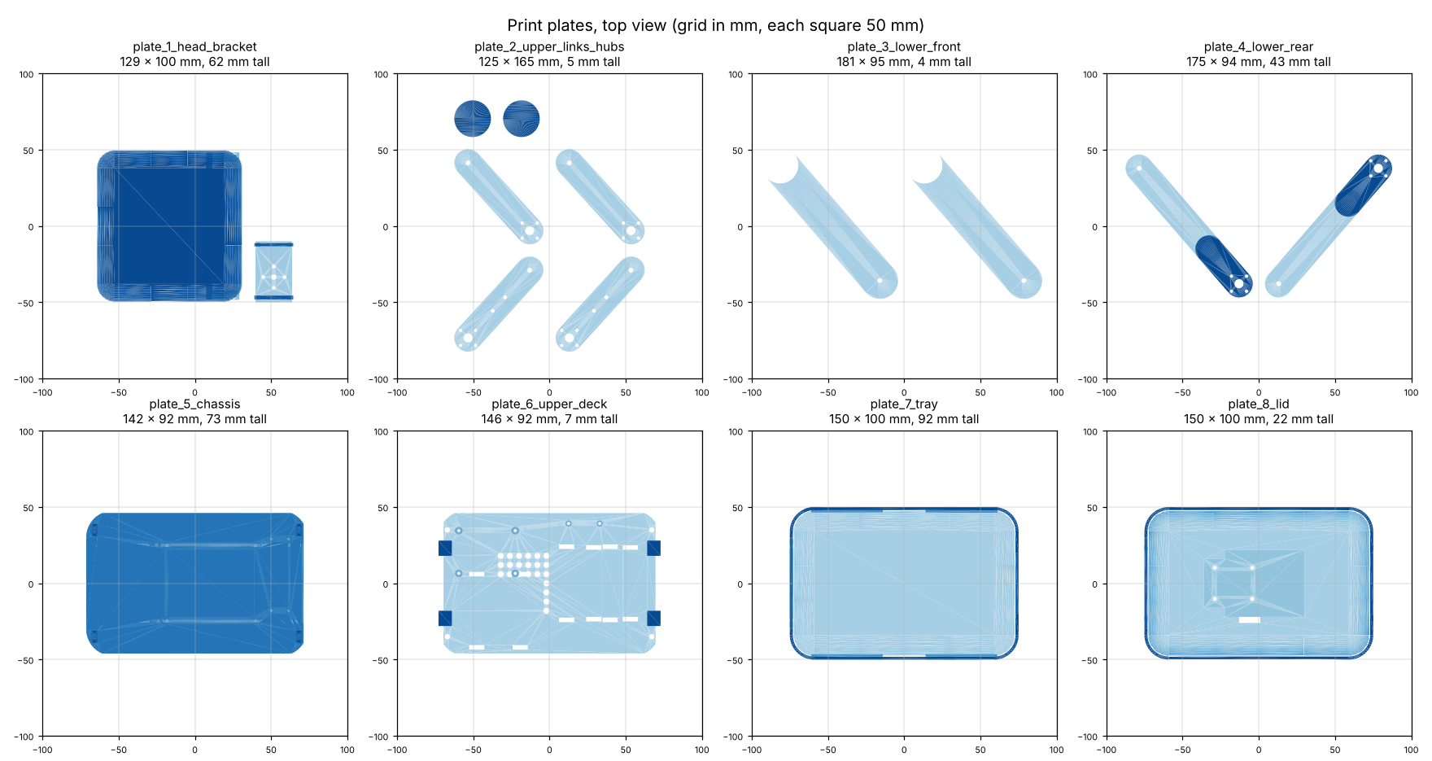
renders/print_plates.png
