mofe64/roadRunnerMiniV1/renders/coupon_tests_3_4.png

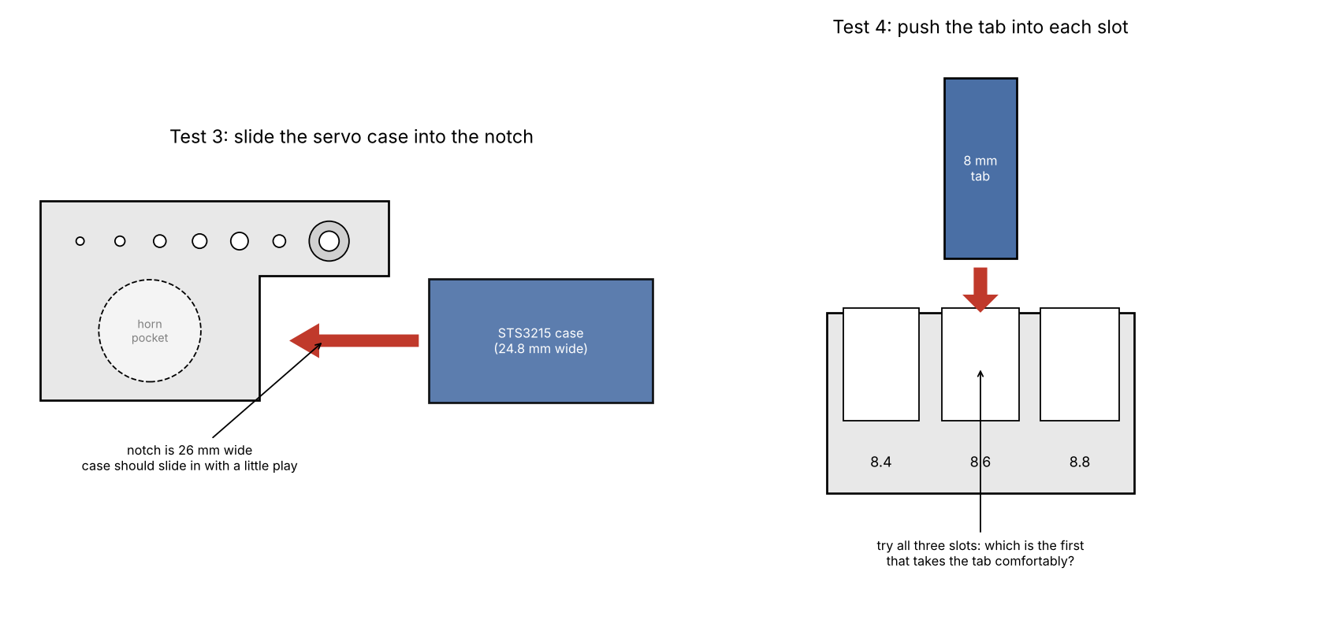
renders/coupon_tests_3_4.png
