mofe64/roadRunnerMiniV1/(commit log)

2026-10-27 Road Runner Mini v1: CAD (S47), STLs, print plates, sim, RL area, docs
    [biped_v02_S47.f3d, chassis.stl, coupon_all.stl, coupon_fork.stl, coupon_horn_gauge.stl, coupon_plate.stl, coupon_tab.stl, head.stl]
2026-10-31 Sync Mac: CAD S67, sim, RL, Pi program
    [axle_L.stl, axle_R.stl, biped_v02_S47.f3d, biped_v02_S51.f3d, biped_v02_S61b.f3d, biped_v02_S62.f3d, biped_v02_S63.f3d, biped_v02_S64.f3d]
2026-10-31 calibrate: separate steps
2026-10-31 calibrate: retry
2026-10-31 calibrate: centre servo offsets
2026-10-31 calibrate: free wheels, retry
2026-10-31 wheel PWM sign
2026-10-31 set_gains: one servo option
2026-10-31 sim: measured fast hip servo, hold odometer
    [hip_bench_20261031_221856.csv, hip_bench_20261031_231154_8deg.csv, hip_bench_20261031_231209_20deg.csv]
2026-11-01 buzz tests: gyro_fast, freeze-hips; sim_test stand pose fix
    [run_brain.py, sim_test.py]
2026-11-01 run_brain: gyro low-pass, fast IMU log
2026-11-01 drive_022: gyro low-pass, wheel speed from position, leg flex, lighter wheel rotor, hip slew, buzz marks
    [balance_env.py, controller.py, drive_env.py, export_brain.py, filters.py, run_brain.py, sim_test.py]
2026-11-01 drive_024: stay in place (long stands, hold score), IMU bias 2 deg, buzz floor
    [balance_env.py, buzz_report.py, drive_env.py]
2026-11-01 drive_027: 2 cm hold zone
2026-11-01 IMU filter shared with the sim, --imu-tau, raw accel in the log
2026-11-01 run_brain: drive_026 default, IMU filter 2 s
2026-11-01 Depth camera: camera check and nearest obstacle distance
2026-11-01 Head pitch tool, save camera picture
2026-11-01 Clean up old runs, brains and scripts; run_brain uses drive_026 and IMU filter 2 s
2026-11-01 Restructure: robot/ for the Pi code, rl/ for training
    [spinup_1.csv, wheel_bench_1.csv]
2026-11-01 Depth: indoor distances (turn 35 cm, stop 20 cm)
2026-11-01 Explore: ignore one-frame depth blips
2026-11-01 Depth: record colour + depth + odometry for the 3D map
2026-11-01 RL: wobble score against the 3.5 Hz rocking, stress card lines, drive_031
    [balance_env.py, buzz_report.py, controller.py, drive_env.py, export_brain.py, filters.py, sim_test.py]
2026-11-02 drive_037: measured senses, late hip speed, wheel rotor fix, frozen games
    [balance_env.py, drive_env.py]
2026-11-02 drive_038: servo-style hip speed timing, IMU age option, stepped command option
2026-11-02 log hip servo load and target
2026-11-02 drive_039: stepped commands, measured wheel gain and balance point
2026-11-02 run_brain: drive_039 default, --depth starts the camera itself
2026-11-02 Explore: smooth VFH steering, manual stop 15 cm
2026-11-03 cad changes
    [biped_v02_S68.f3d, chassis_lower.stl, plate_5a_chassis_lower.3mf]
2026-11-06 CAD S69 and S70: base openings for hip screw access, tray front joint, round deck pockets, adapter post base
    [biped_v02_S69.f3d, biped_v02_S70.f3d, chassis_lower.stl, chassis_upper.stl, plate_5a_chassis_lower.3mf, plate_5b_chassis_upper.3mf, plate_6_upper_deck.3mf, plate_7_tray.3mf]
2026-11-06 12 V STS3215 on battery voltage, remove the 7.4 V UBEC; add BOM for S70
2026-11-11 CAD S72 upper deck and IMU plate; rewrite the documentation
    CAD S72: both bus servo adapters at the rear of the upper deck, cable channel, 2 UBEC places with tie slots, new IMU plate on the lower deck posts (plate 9). Do not print plates 6 and 9 from this state: cable slots and a tie slot move come in S73.
    Docs: README, BOM, DESIGN, PARTS, PRINT, the assembly guide and the robot, sim and rl READMEs describe the current design. Hip and head servos are 7.4 V on UBEC 2; only the wheel servos get battery voltage. Servo IDs, fastener counts and the default brain are corrected.
    [biped_v02_S72.f3d, imu_plate.stl, plate_6_upper_deck.3mf, plate_9_imu_plate.3mf, upper_deck.stl]
